mouhandiaye/Kicad/Models/Capacitance_To_Digital/RGH0016A.stp

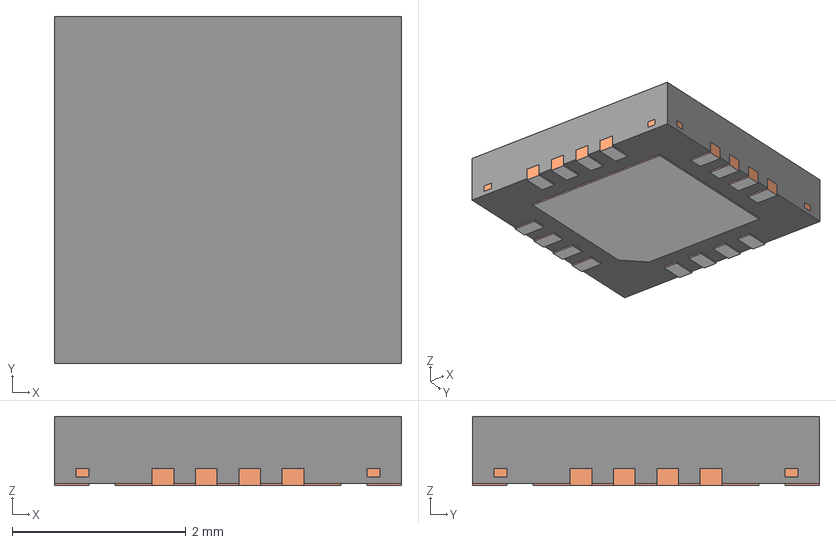
[picture p1: CAD file, 2022-08-02]
Models/Capacitance_To_Digital/RGH0016A.stp
4.00 x 4.00 x 0.8 mm
BODY-QFN
FRAME-RGH0016A
PIN1-ID
