mouhandiaye/Kicad/Models/CMS_ADC/ADS7028IRTER.stp

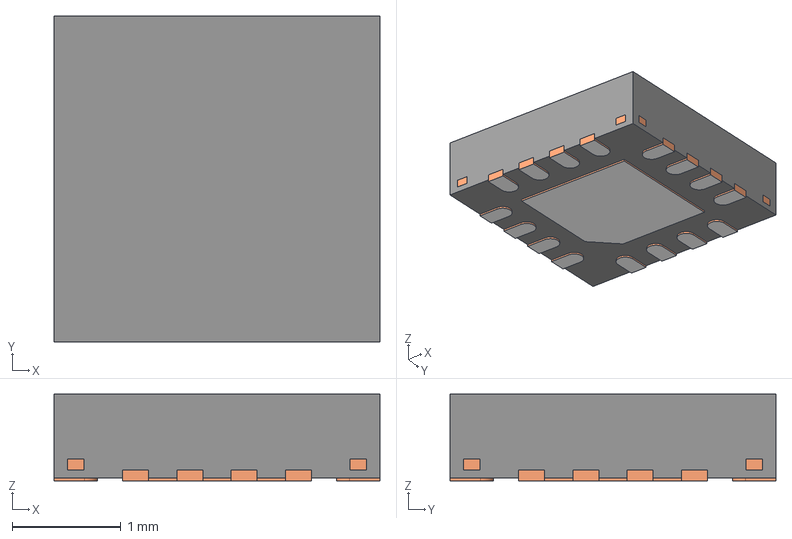
[picture p2: CAD file, 2022-08-26]
Models/CMS_ADC/ADS7028IRTER.stp
3.00 x 3.00 x 0.8 mm
BODY-QFN
FRAME-RTE0016C
PIN1-ID
