mouhandiaye/Kicad/Models/CMS_Antenna/ACAG0201-2450-T.stp

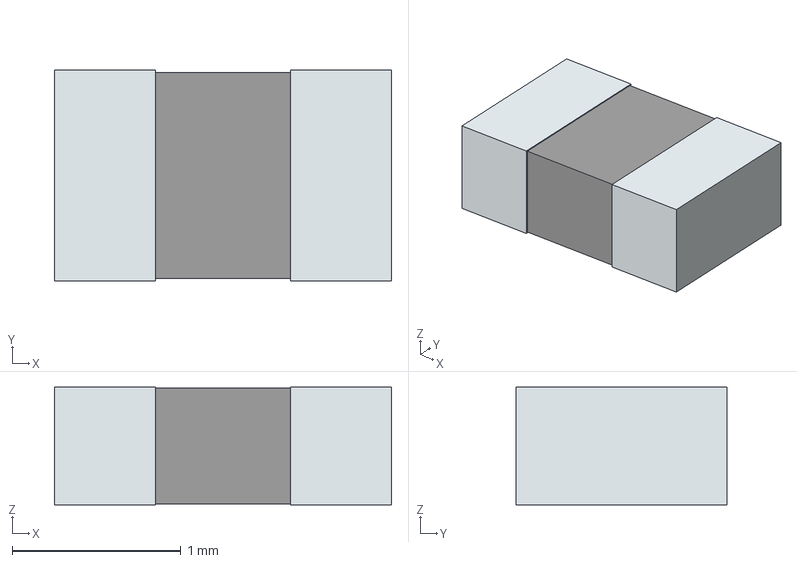
[picture p3: CAD file, 2022-08-25]
Models/CMS_Antenna/ACAG0201-2450-T.stp
2.00 x 1.25 x 0.7 mm
term1
term2
