mouhandiaye/Kicad/Models/CMS_AOP/MCP6N16-010E_MS.stp

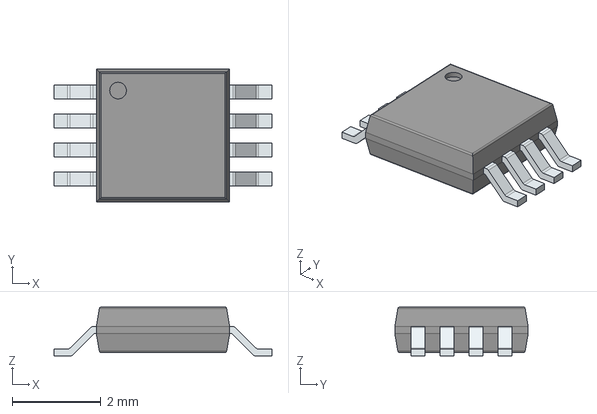
[picture p4: CAD file, 2022-08-02]
Models/CMS_AOP/MCP6N16-010E_MS.stp
4.90 x 3.00 x 1.10 mm
PinsArrayLR
