mouhandiaye/Kicad/Models/CMS_Capacitor/CAP_1608_TDK.step

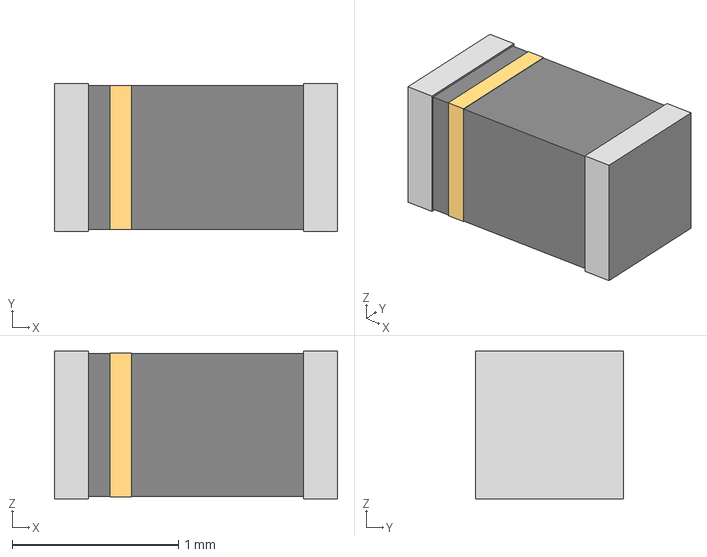
[picture p5: CAD file, 2022-08-02]
Models/CMS_Capacitor/CAP_1608_TDK.step
1.70 x 0.888 x 0.889 mm
