mouhandiaye/Kicad/Models/CMS_Counter/IC-MDTSSOP20.stp

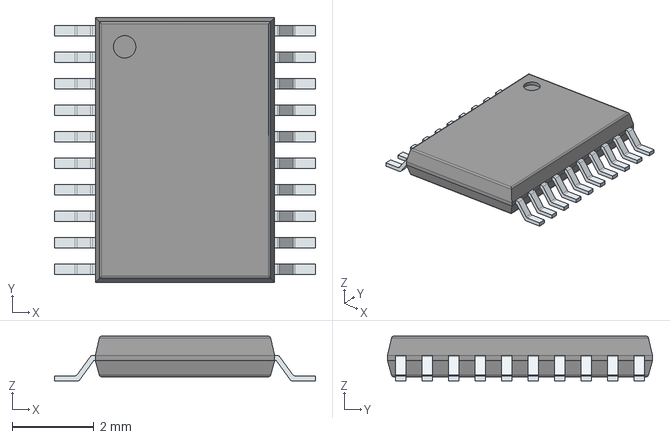
[picture p6: CAD file, 2022-08-02]
Models/CMS_Counter/IC-MDTSSOP20.stp
6.40 x 6.50 x 1.10 mm
PinsArrayLR
