mouhandiaye/Kicad/Models/CMS_DC_DC/LT3991EMSE-3.3PBF.stp

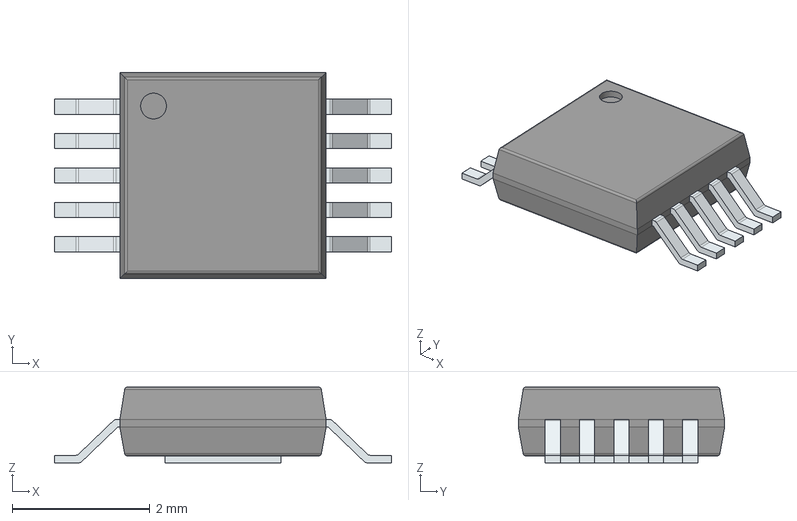
[picture p7: CAD file, 2022-08-25]
Models/CMS_DC_DC/LT3991EMSE-3.3PBF.stp
4.90 x 3.00 x 1.10 mm
PinsArrayLR
ThermalPad
