mouhandiaye/Kicad/Models/CMS_EEPROM/24FC512-I_MF.stp

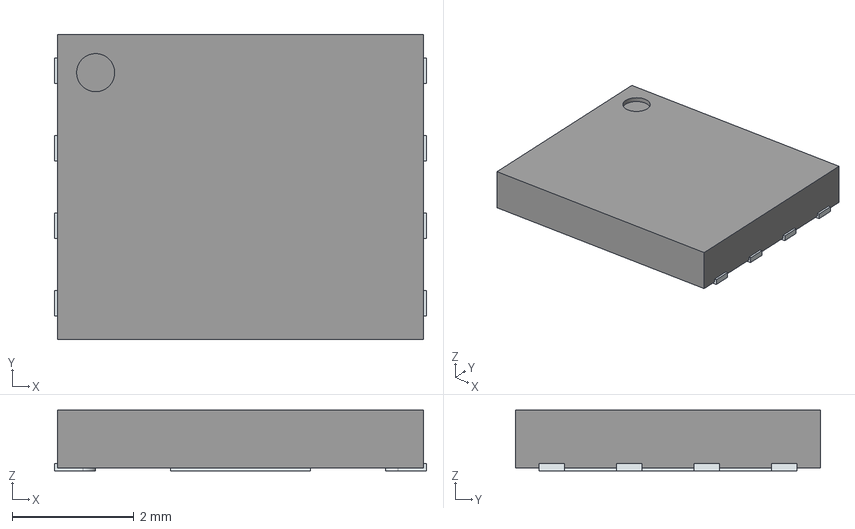
[picture p8: CAD file, 2022-08-25]
Models/CMS_EEPROM/24FC512-I_MF.stp
6.10 x 5.00 x 1.00 mm
ThermalPin
PinsArrayLR
