mouhandiaye/Kicad/Models/CMS_ESD_Protection/NSR0530HT1G.stp

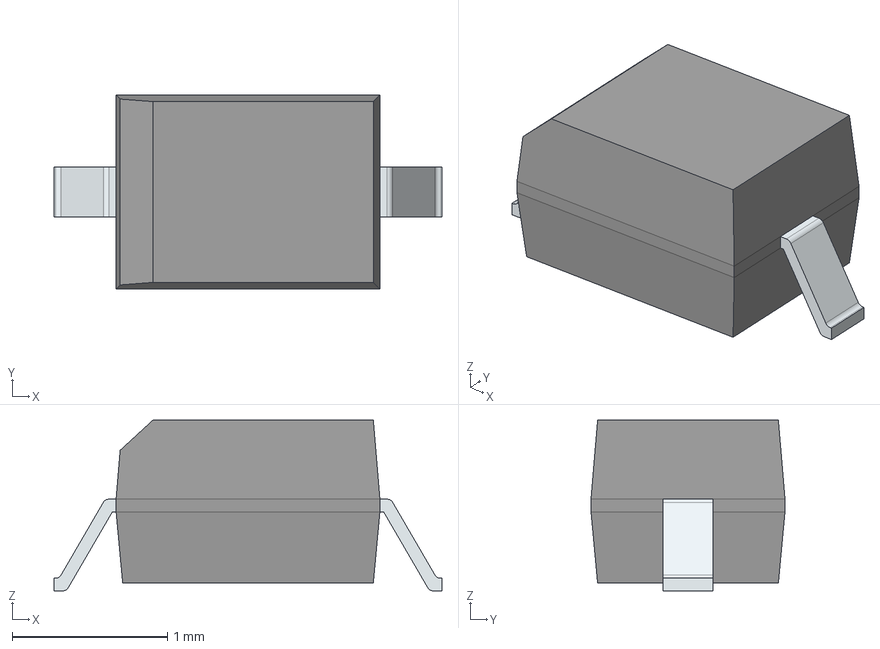
[picture p9: CAD file, 2022-08-26]
Models/CMS_ESD_Protection/NSR0530HT1G.stp
2.50 x 1.25 x 1.10 mm
FilletPinL
FilletPinR
