mouhandiaye/Kicad/Models/CMS_Ferrite/BLM18EG221SN1D.stp

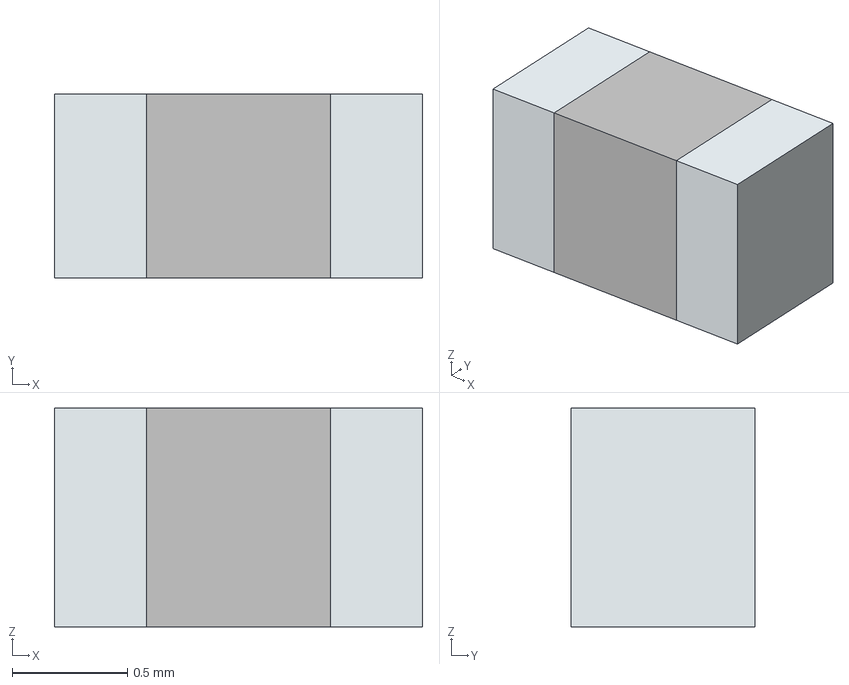
[picture p10: CAD file, 2022-08-25]
Models/CMS_Ferrite/BLM18EG221SN1D.stp
1.60 x 0.8 x 0.95 mm
solidBody
solidLead
