mouhandiaye/Kicad/Models/CMS_HARWIN/G125-MS11005L3P.stp

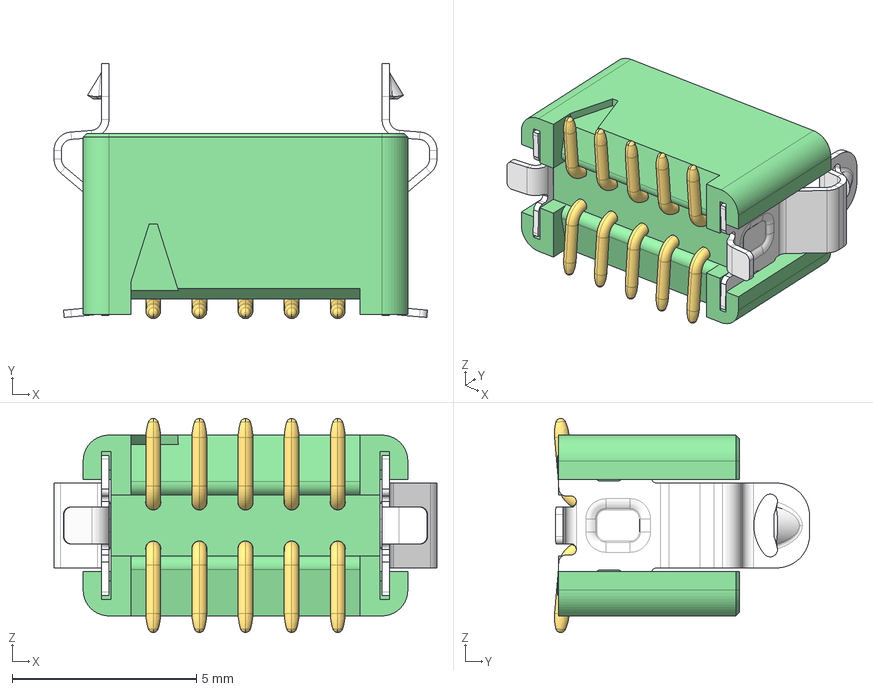
[picture p11: CAD file, 2022-08-02]
Models/CMS_HARWIN/G125-MS11005L3P.stp
10.4 x 6.92 x 5.80 mm
G125-3011096
G125-1050005_BENT x 10
G125-412 x 2
