mouhandiaye/Kicad/Models/CMS_HIROSE/BM46B-12DS-0.35V_51_.step

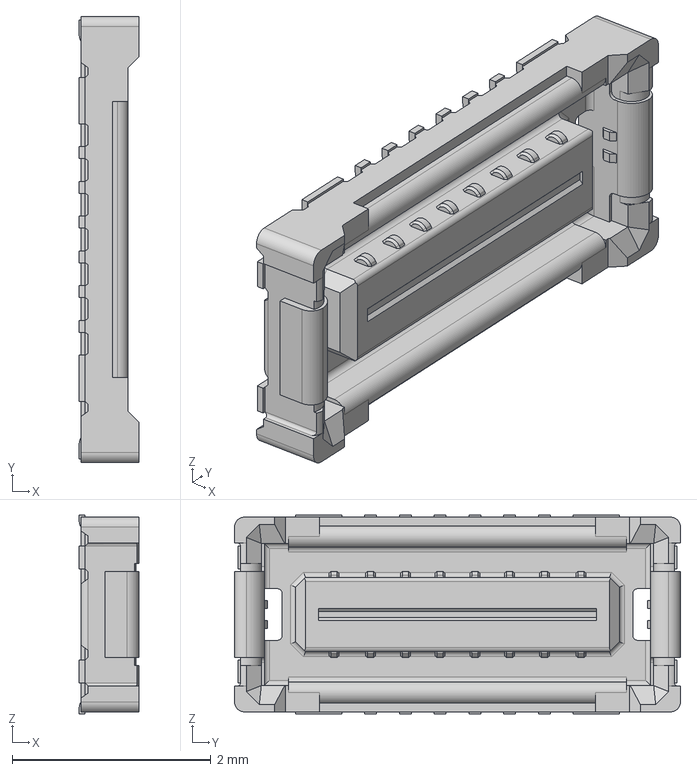
[picture p12: CAD file, 2022-08-02]
Models/CMS_HIROSE/BM46B-12DS-0.35V_51_.step
0.6 x 4.49 x 2.00 mm
