mouhandiaye/Kicad/Models/CMS_HIROSE/DF12N/DF12NB(3.0)-80DS.stp

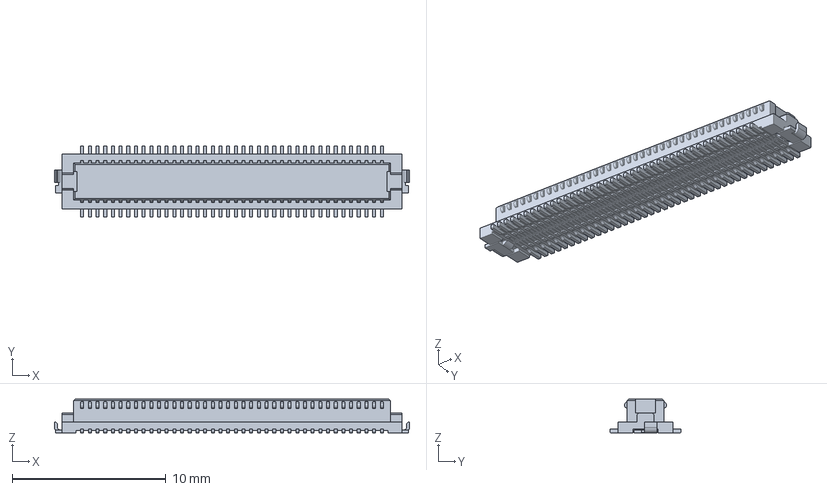
[picture p13: CAD file, 2022-08-02]
Models/CMS_HIROSE/DF12N/DF12NB(3.0)-80DS.stp
23.1 x 4.60 x 2.20 mm
