mouhandiaye/Kicad/Models/CMS_IMU/LSM6DS3TR-C.stp

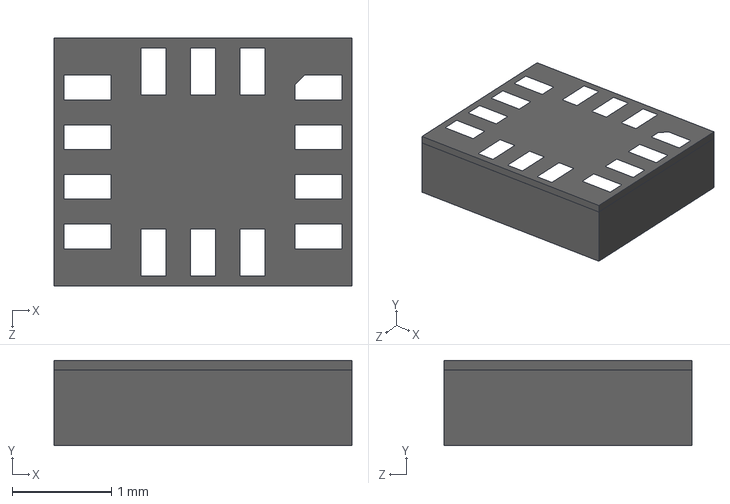
[picture p14: CAD file, 2022-08-25]
Models/CMS_IMU/LSM6DS3TR-C.stp
3.00 x 0.86 x 2.50 mm
