mouhandiaye/Kicad/Models/CMS_LAN/LAN9252I_PT.stp

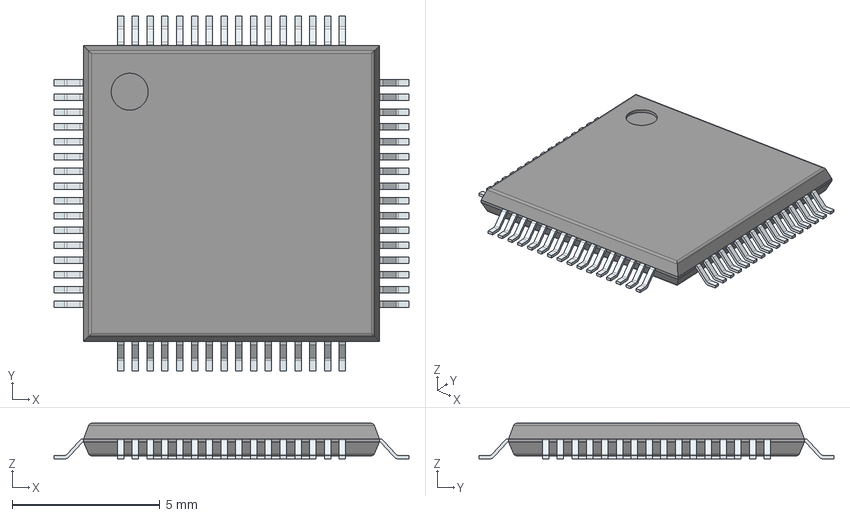
[picture p15: CAD file, 2022-08-25]
Models/CMS_LAN/LAN9252I_PT.stp
12.0 x 12.0 x 1.20 mm
PinsArrayLR
PinsArrayTB
ThermalPad
