mouhandiaye/Kicad/Models/CMS_Led/LED_150120RS75000_WRE.step

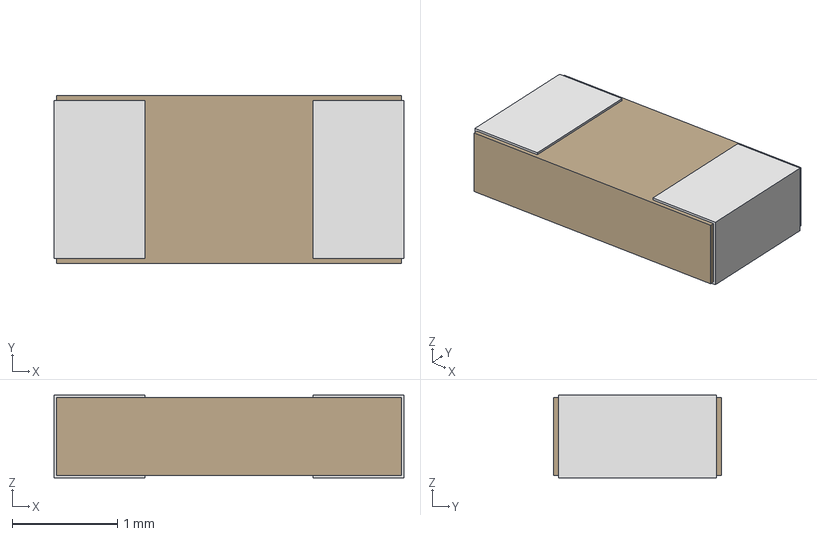
[picture p16: CAD file, 2022-08-02]
Models/CMS_Led/LED_150120RS75000_WRE.step
3.33 x 1.60 x 0.787 mm
