mouhandiaye/Kicad/Models/CMS_LEVEL_SHIFT/21-0137I_T1433-2_MXM.step

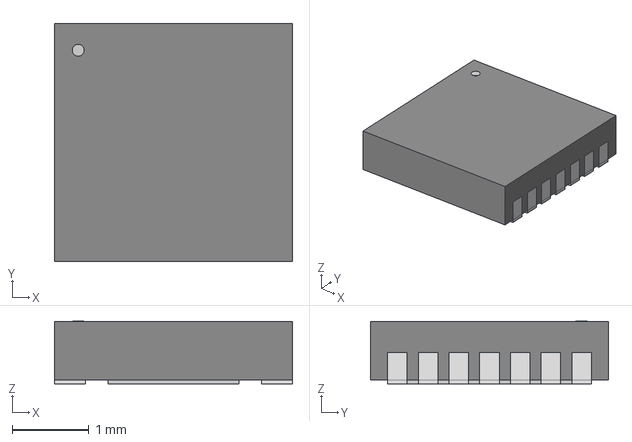
[picture p17: CAD file, 2022-08-02]
Models/CMS_LEVEL_SHIFT/21-0137I_T1433-2_MXM.step
3.10 x 3.10 x 0.815 mm
