mouhandiaye/Kicad/Models/CMS_Logic/NAND/74AHCT2G08DP_125_NEX.step

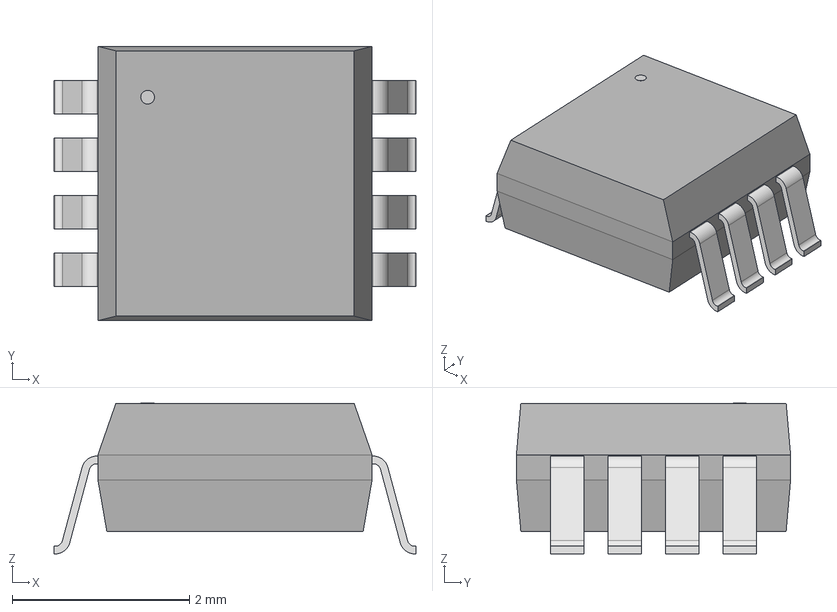
[picture p18: CAD file, 2022-08-02]
Models/CMS_Logic/NAND/74AHCT2G08DP_125_NEX.step
4.09 x 3.10 x 1.70 mm
