mouhandiaye/Kicad/Models/CMS_Magnetometer/LIS2MDLTR.stp

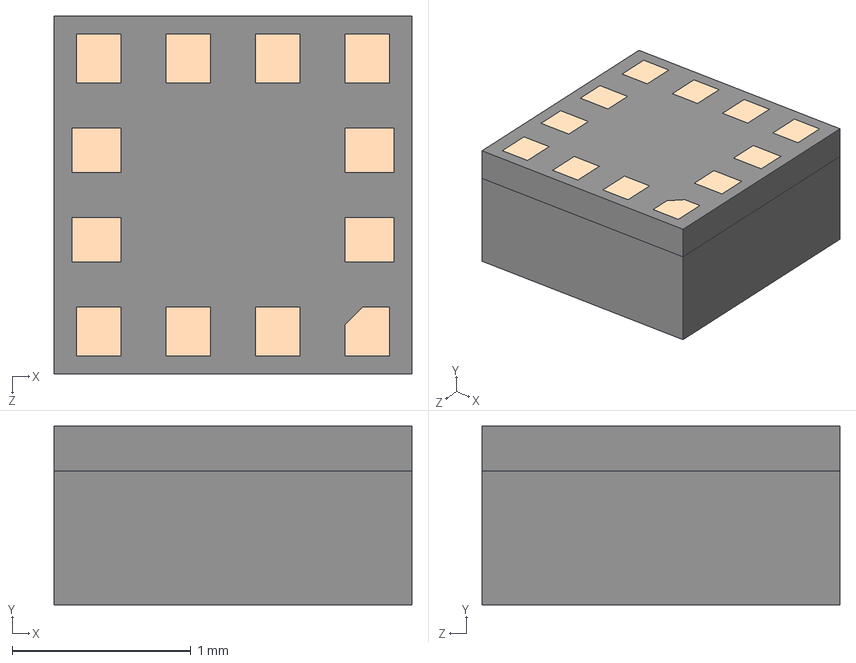
[picture p19: CAD file, 2022-08-02]
Models/CMS_Magnetometer/LIS2MDLTR.stp
2.00 x 1.00 x 2.00 mm
