mouhandiaye/Kicad/Models/CMS_MCU/STM32L010K4T6.stp

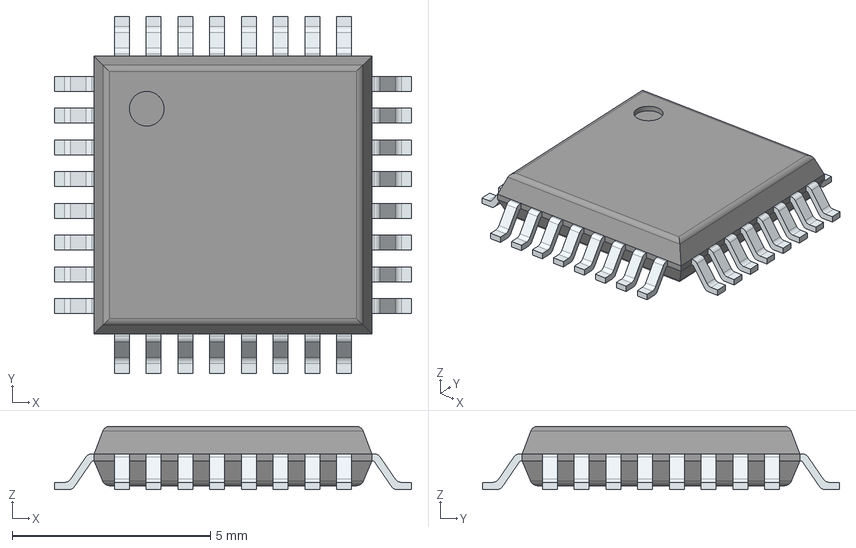
[picture p20: CAD file, 2022-08-02]
Models/CMS_MCU/STM32L010K4T6.stp
9.00 x 9.00 x 1.60 mm
PinsArrayLR
PinsArrayTB
