mouhandiaye/Kicad/Models/CMS_Oscillator/MCSJK-3N-25.00-3.3-25-B.stp

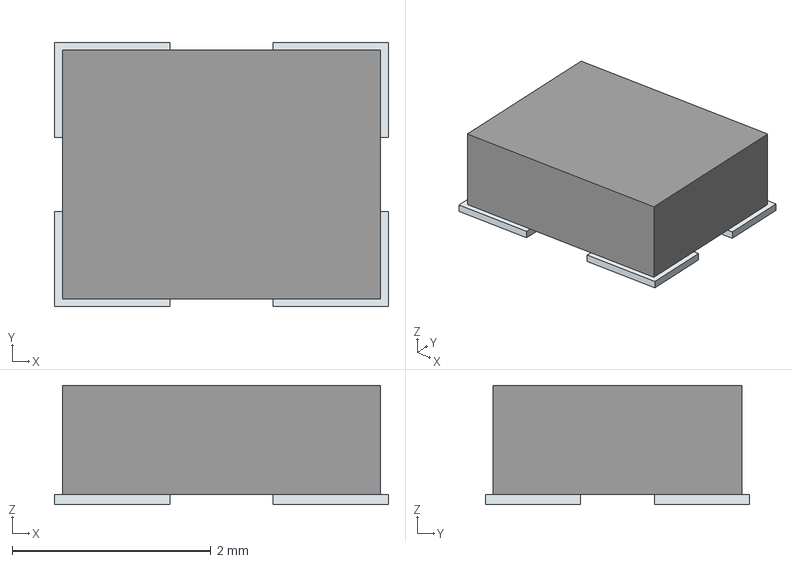
[picture p21: CAD file, 2022-08-02]
Models/CMS_Oscillator/MCSJK-3N-25.00-3.3-25-B.stp
3.36 x 2.66 x 1.20 mm
Pins
