mouhandiaye/Kicad/Models/CMS_Push_Button/KMR223GLFG.stp

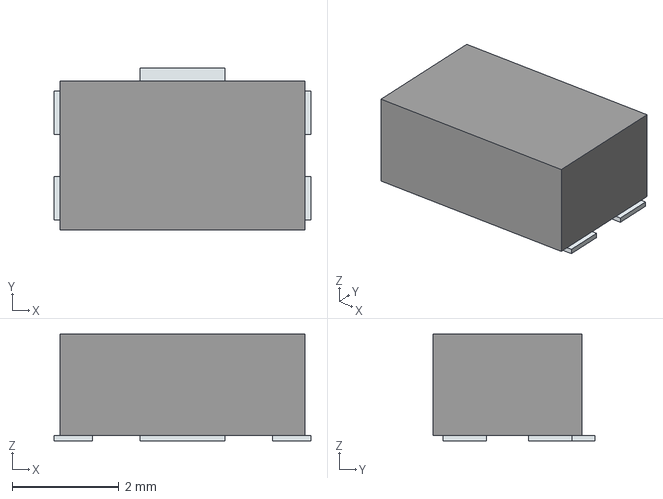
[picture p22: CAD file, 2022-08-26]
Models/CMS_Push_Button/KMR223GLFG.stp
4.82 x 3.04 x 2.00 mm
Pins
