mouhandiaye/Kicad/Models/CMS_Quartz/8Z-25.000MAAJ-T.stp

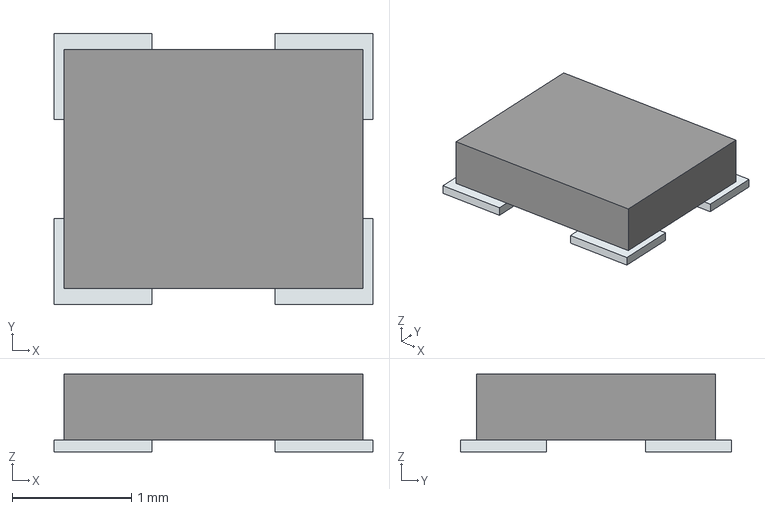
[picture p23: CAD file, 2022-08-25]
Models/CMS_Quartz/8Z-25.000MAAJ-T.stp
2.67 x 2.27 x 0.65 mm
Pins
