mouhandiaye/Kicad/Models/CMS_Rectifier/RBS1MM40ATR.stp

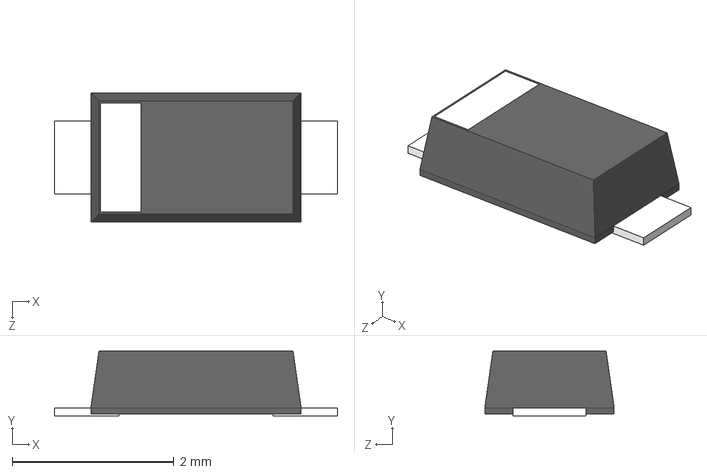
[picture p24: CAD file, 2022-08-25]
Models/CMS_Rectifier/RBS1MM40ATR.stp
3.50 x 0.8 x 1.60 mm
