mouhandiaye/Kicad/Models/CMS_Resistor/RC0603N_YAG.step

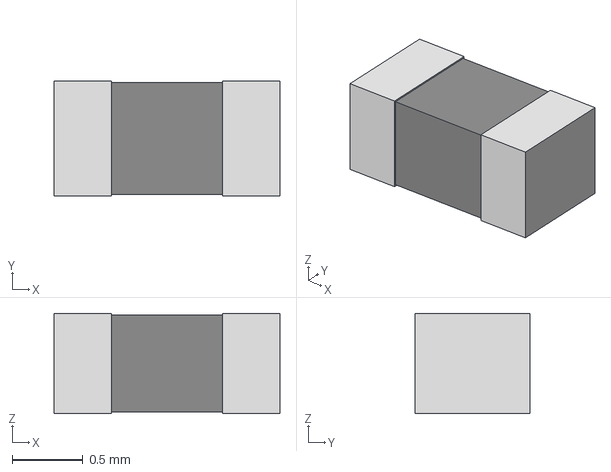
[picture p25: CAD file, 2022-08-02]
Models/CMS_Resistor/RC0603N_YAG.step
1.60 x 0.812 x 0.711 mm
