mouhandiaye/Kicad/Models/CMS_Samtec/LSHM-120-02.5-L-DV-A-S-K-TR.step

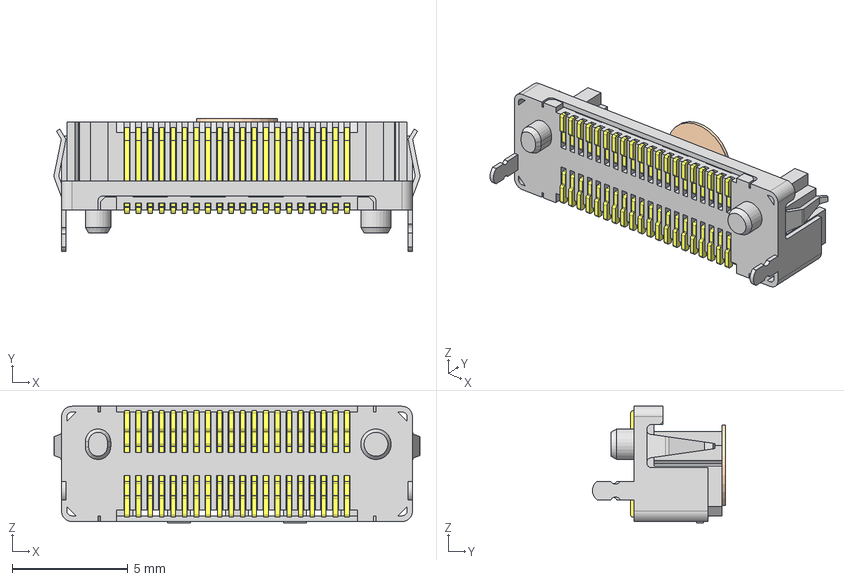
[picture p26: CAD file, 2022-08-25]
Models/CMS_Samtec/LSHM-120-02.5-L-DV-A-S-K-TR.step
15.8 x 5.75 x 5.03 mm
K-DOT-.138-.250-.005.pp
C-185--20-02.5-DV1P
LSHM-20-02.5-DV-A-S_STRIP
