mouhandiaye/Kicad/Models/CMS_Schottky/DSN2.step

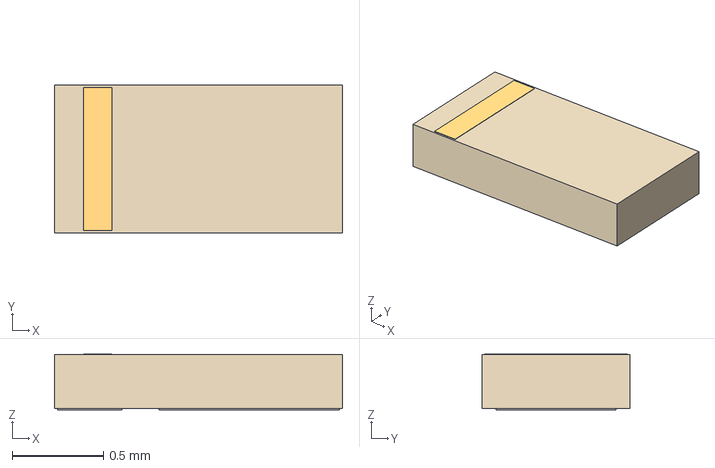
[picture p27: CAD file, 2022-08-25]
Models/CMS_Schottky/DSN2.step
1.58 x 0.812 x 0.307 mm
