mouhandiaye/Kicad/Models/CMS_Transformer&Choke/ALT4532M-201-T001.stp

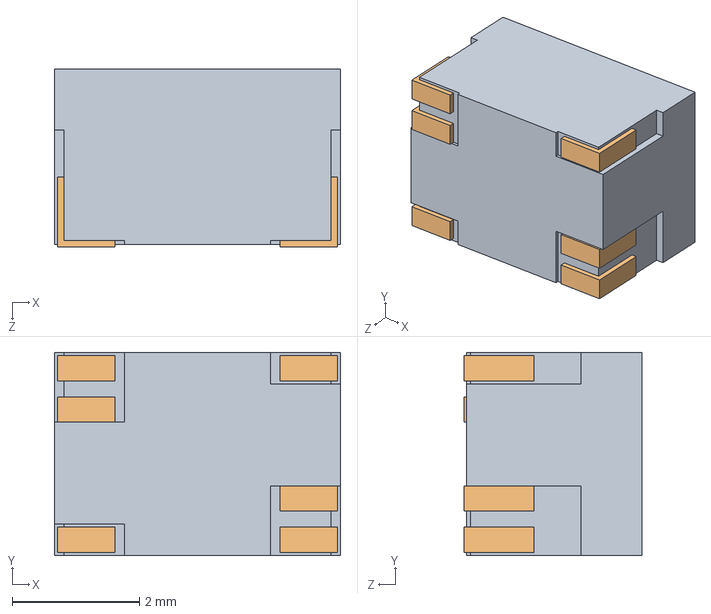
[picture p28: CAD file, 2022-08-25]
Models/CMS_Transformer&Choke/ALT4532M-201-T001.stp
4.50 x 3.20 x 2.80 mm
ALT4532M-201 DRコアブロック(typ size)
ALT4532M-201 端子ブロック(typ size) x 6
