mouhandiaye/Kicad/Models/CMS_Voltage_Regulator/SOT23-5L_STM.step

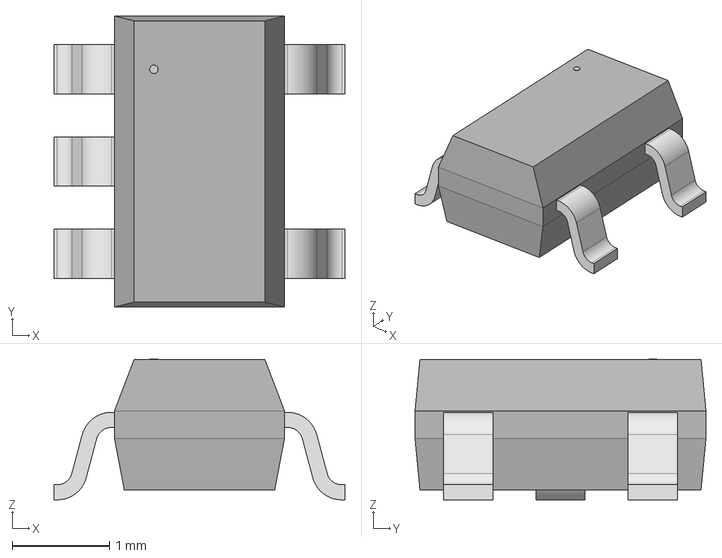
[picture p29: CAD file, 2022-08-02]
Models/CMS_Voltage_Regulator/SOT23-5L_STM.step
3.00 x 3.00 x 1.45 mm
