mouhandiaye/Kicad/Models/FPC/F32R-1A7H1-11008.stp

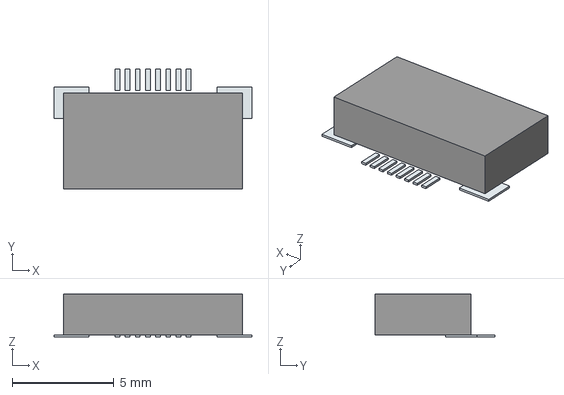
[picture p30: CAD file, 2022-08-02]
Models/FPC/F32R-1A7H1-11008.stp
9.71 x 5.87 x 2.10 mm
Pins
