mouhandiaye/Kicad/Models/CMS_Antenna/MLPF-WB55-02E3.stp

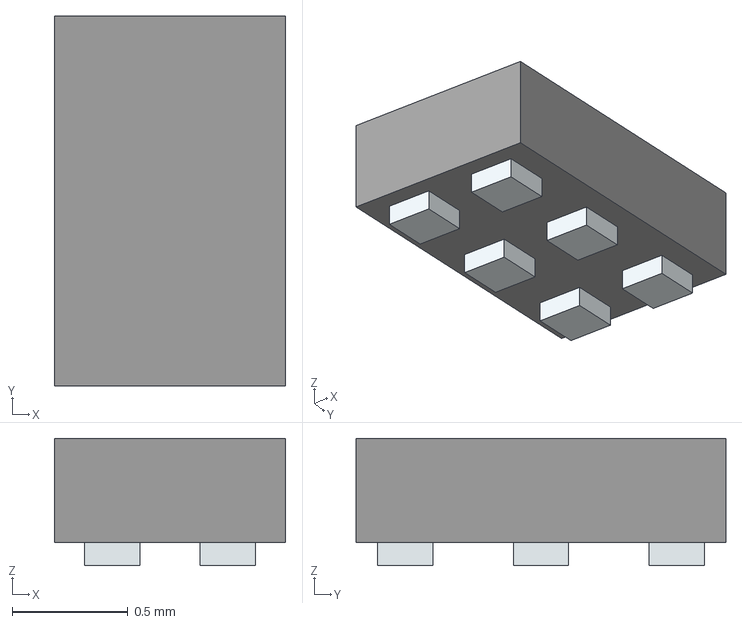
[picture p32: CAD file, 2022-08-25]
Models/CMS_Antenna/MLPF-WB55-02E3.stp
1.00 x 1.60 x 0.55 mm
Pins
