mouhandiaye/Kicad/Models/CMS_BATT_CHARG/DFN8_2x3MC_MCH.step

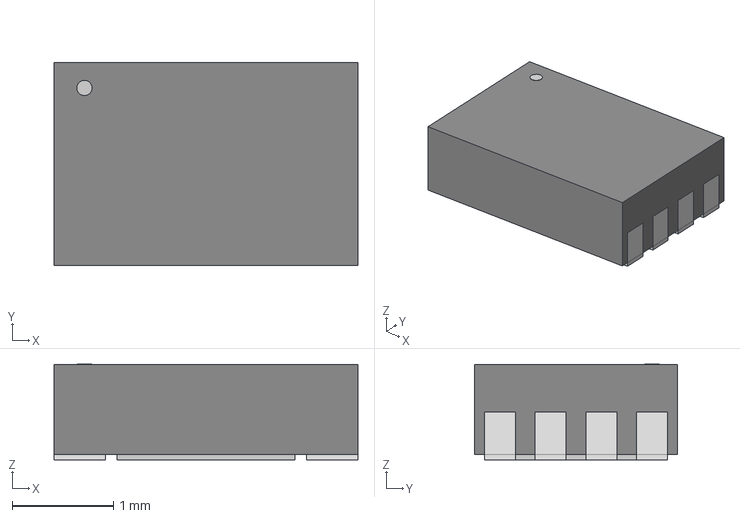
[picture p33: CAD file, 2022-08-02]
Models/CMS_BATT_CHARG/DFN8_2x3MC_MCH.step
3.00 x 2.01 x 0.942 mm
