mouhandiaye/Kicad/Models/CMS_Capacitor/YAG_CC0402_YAG.step

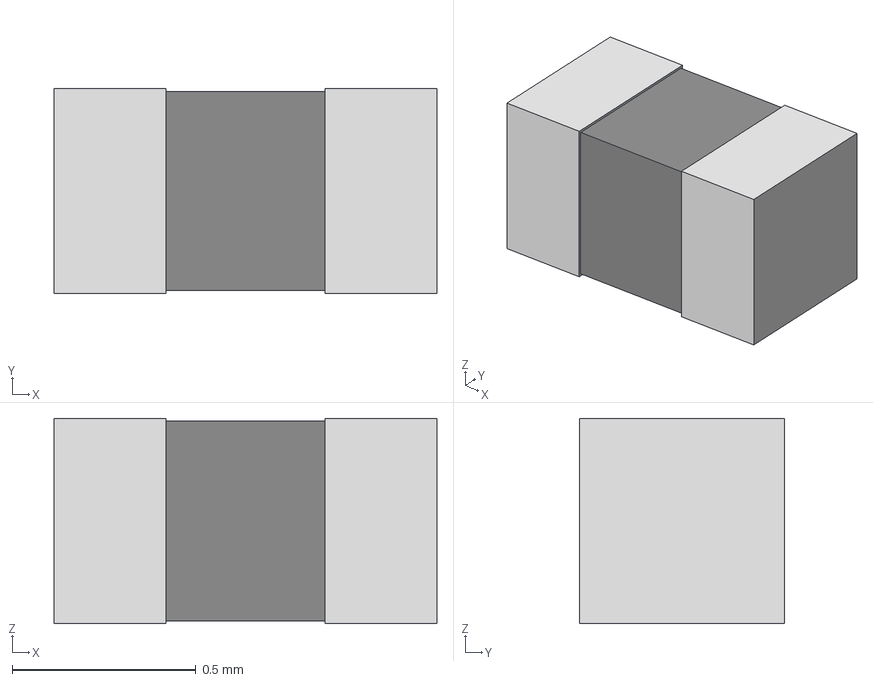
[picture p34: CAD file, 2022-08-02]
Models/CMS_Capacitor/YAG_CC0402_YAG.step
1.04 x 0.558 x 0.559 mm
