mouhandiaye/Kicad/Models/CMS_Ferrite/IND_1005_TDK.step

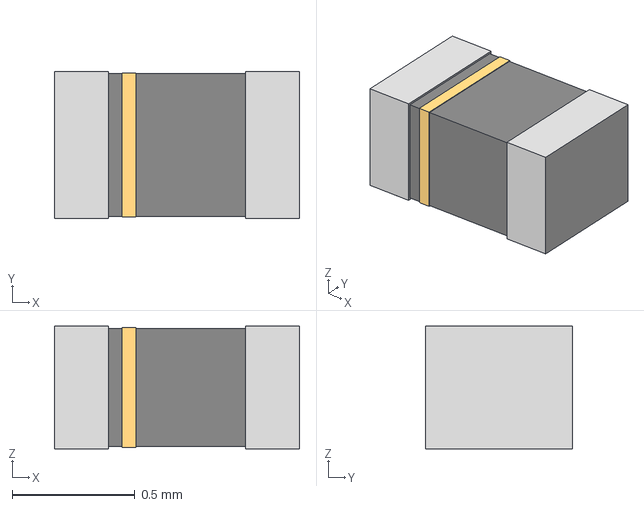
[picture p35: CAD file, 2022-08-02]
Models/CMS_Ferrite/IND_1005_TDK.step
1.00 x 0.6 x 0.5 mm
