mouhandiaye/Kicad/Models/CMS_HIROSE/BM46B-12DP-0.35V_51_.step

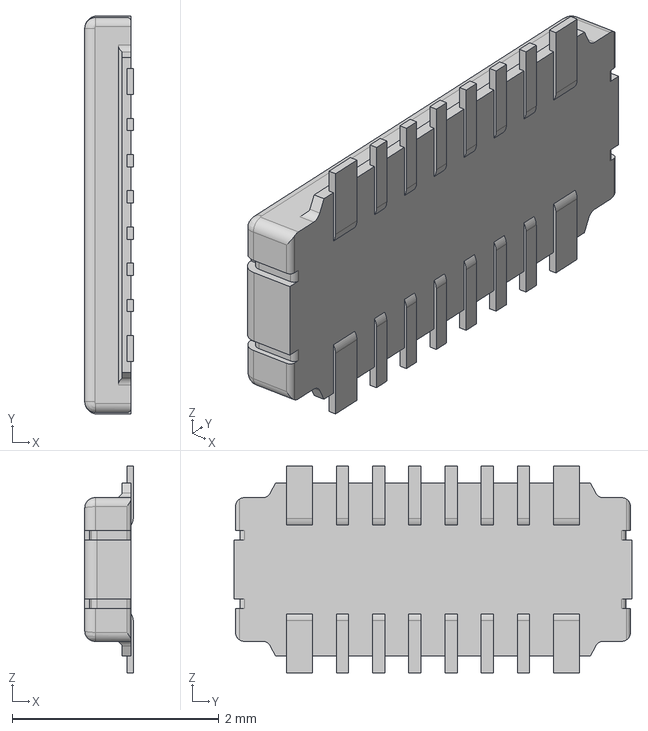
[picture p36: CAD file, 2022-08-02]
Models/CMS_HIROSE/BM46B-12DP-0.35V_51_.step
0.47 x 3.85 x 2.00 mm
