mouhandiaye/Kicad/Models/CMS_HIROSE/DF12N/DF12NB(3.0)-60DS.stp

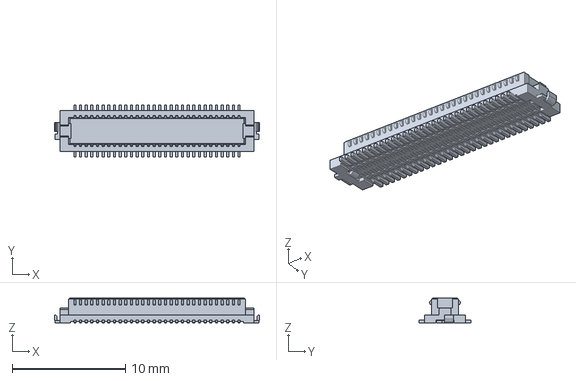
[picture p37: CAD file, 2022-08-02]
Models/CMS_HIROSE/DF12N/DF12NB(3.0)-60DS.stp
18.1 x 4.60 x 2.20 mm
