mouhandiaye/Kicad/Models/CMS_IMU/QFN_6DSLTR_STM.step

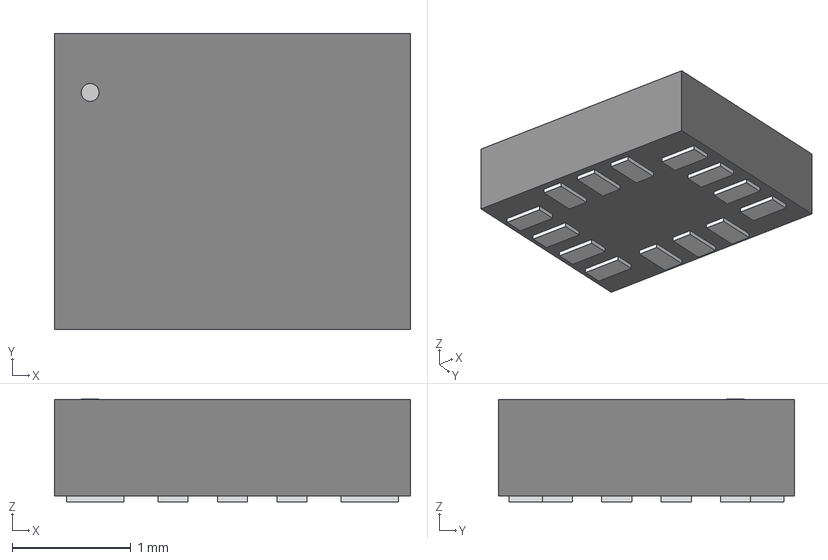
[picture p38: CAD file, 2022-08-02]
Models/CMS_IMU/QFN_6DSLTR_STM.step
3.00 x 2.49 x 0.866 mm
