mouhandiaye/Kicad/Models/CMS_Inductor/LPS5030-123MRC.step

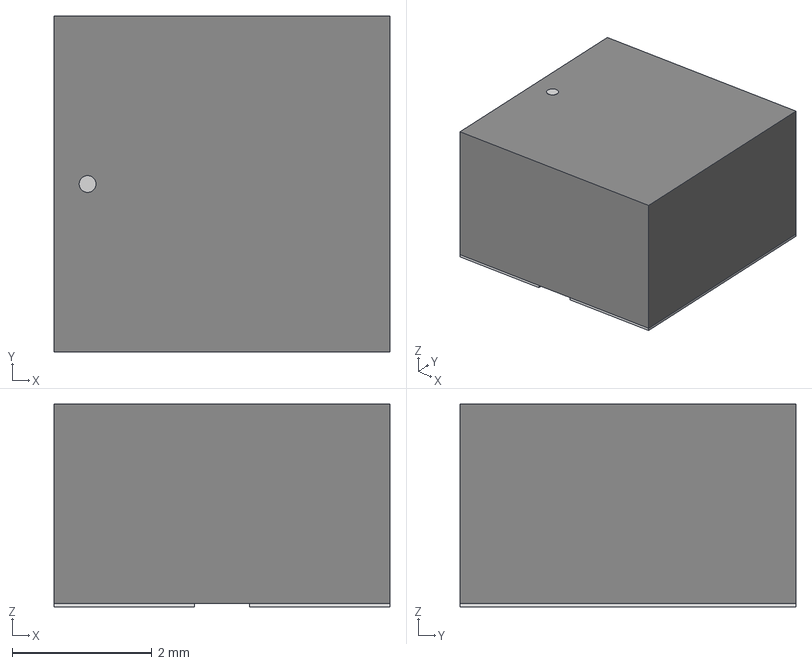
[picture p39: CAD file, 2022-08-25]
Models/CMS_Inductor/LPS5030-123MRC.step
4.80 x 4.80 x 2.90 mm
