mouhandiaye/Kicad/Models/CMS_LEVEL_SHIFT/FXLA0104QFX.stp

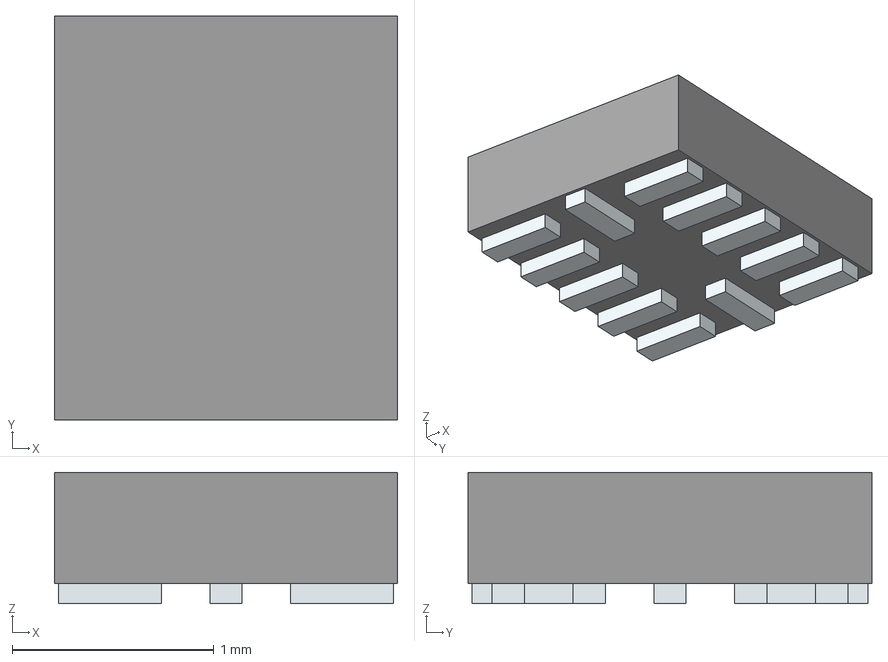
[picture p40: CAD file, 2022-08-02]
Models/CMS_LEVEL_SHIFT/FXLA0104QFX.stp
1.70 x 2.00 x 0.65 mm
Pins
