mouhandiaye/Kicad/Models/CMS_Magnetometer/WLP4_0P82X0P82_MEM.step

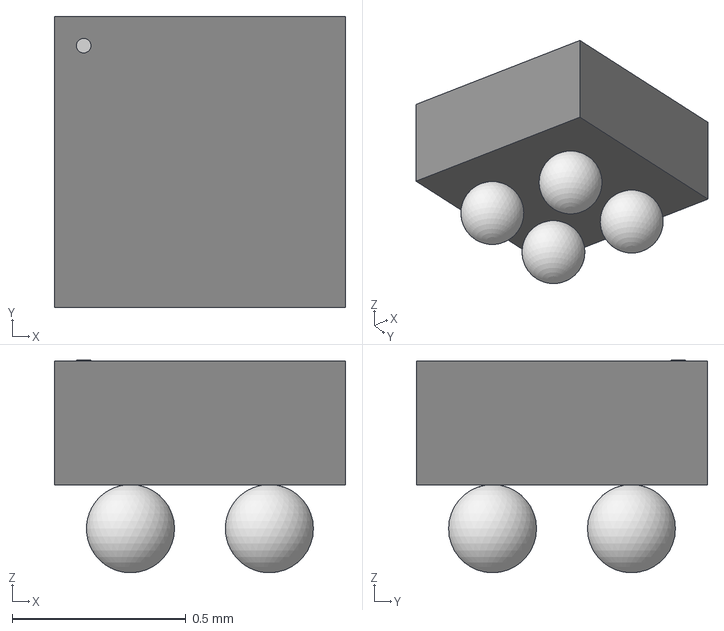
[picture p41: CAD file, 2022-08-02]
Models/CMS_Magnetometer/WLP4_0P82X0P82_MEM.step
0.838 x 0.838 x 0.612 mm
