mouhandiaye/Kicad/Models/CMS_MCU/LQFP-64.step

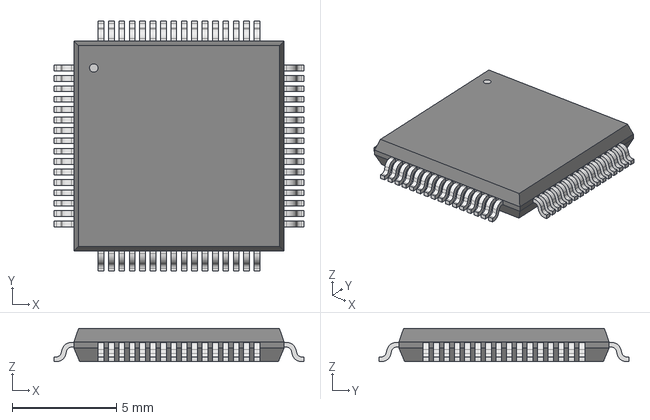
[picture p42: CAD file, 2022-08-02]
Models/CMS_MCU/LQFP-64.step
12.0 x 12.0 x 1.60 mm
