mouhandiaye/Kicad/Models/CMS_Push_Button/PTS647SM70SMTR2LFS.stp

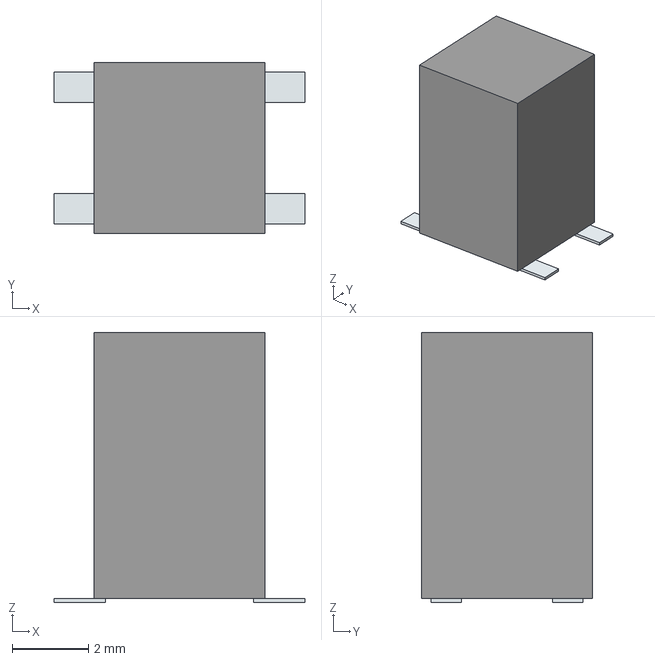
[picture p43: CAD file, 2022-08-25]
Models/CMS_Push_Button/PTS647SM70SMTR2LFS.stp
6.60 x 4.50 x 7.10 mm
Pins
