mouhandiaye/Kicad/Models/CMS_Quartz/XTAL_SC-20S_EPS.step

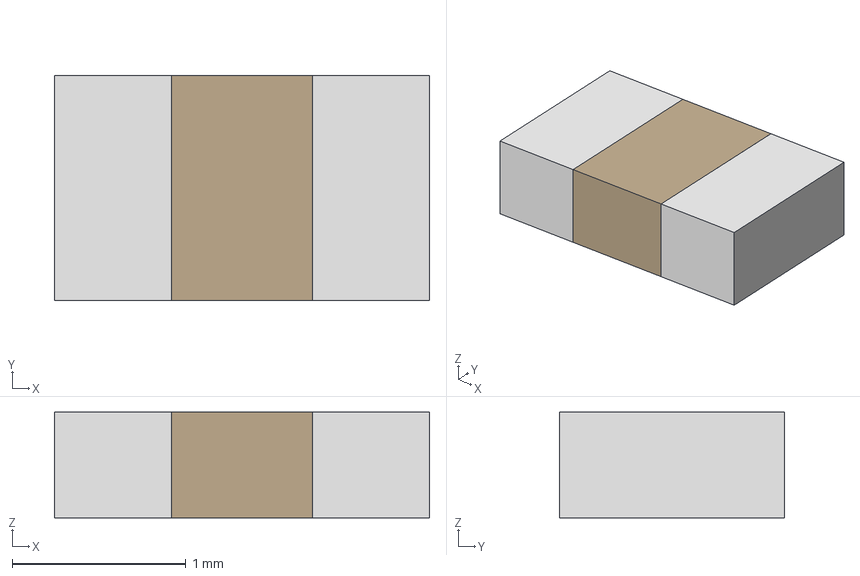
[picture p44: CAD file, 2022-08-25]
Models/CMS_Quartz/XTAL_SC-20S_EPS.step
2.16 x 1.30 x 0.61 mm
