mouhandiaye/Kicad/Models/CMS_Resistor/YAG_AC0402_YAG.step

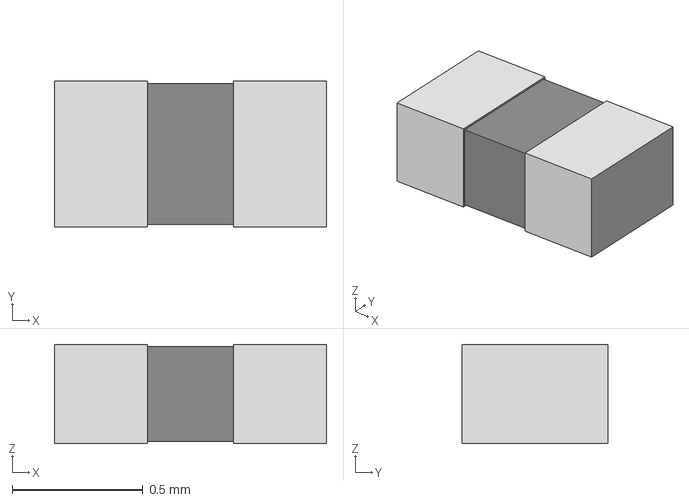
[picture p45: CAD file, 2022-08-02]
Models/CMS_Resistor/YAG_AC0402_YAG.step
1.04 x 0.558 x 0.381 mm
