mouhandiaye/Kicad/Models/CMS_Samtec/LSHM-105-02.5-L-DV-A-S-K-TR.stp

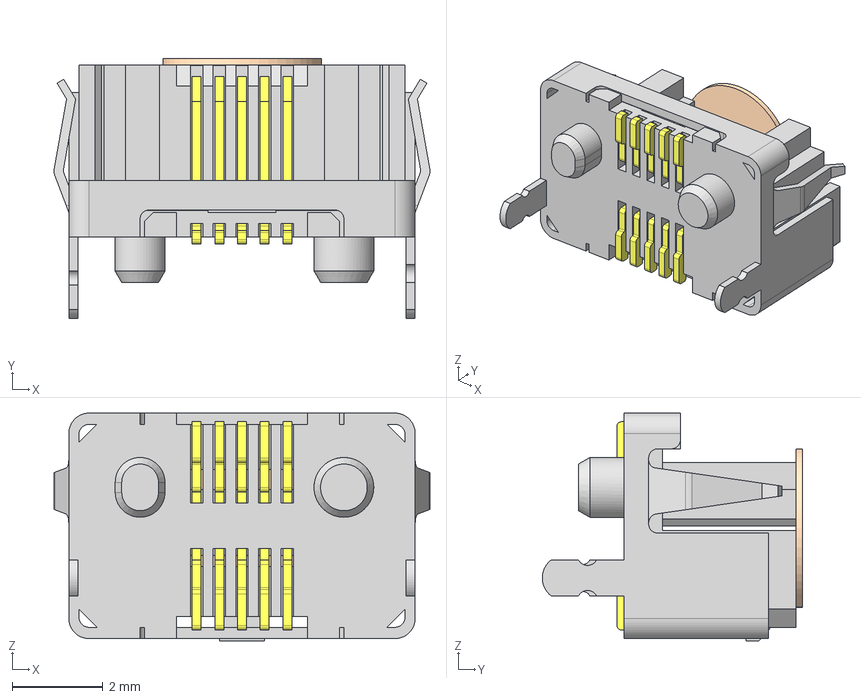
[picture p46: CAD file, 2022-08-25]
Models/CMS_Samtec/LSHM-105-02.5-L-DV-A-S-K-TR.stp
8.30 x 5.75 x 5.03 mm
K-DOT-.138-.250-.005.pp
C-185--05-02.5-DV1P
LSHM-05-02.5-DV-A-S_STRIP
