mouhandiaye/Kicad/Models/CMS_Schottky/MBRA210LT3G.stp

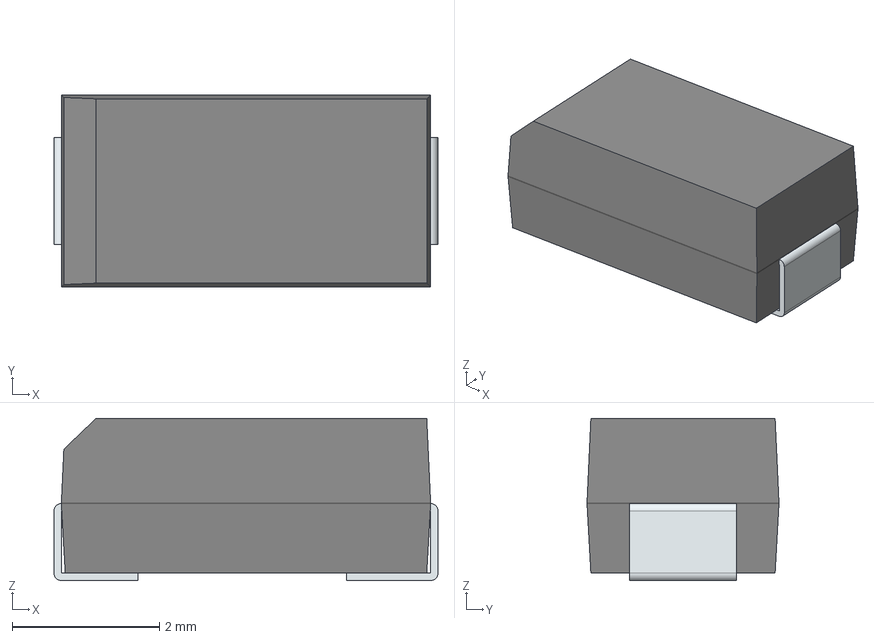
[picture p47: CAD file, 2022-08-25]
Models/CMS_Schottky/MBRA210LT3G.stp
5.21 x 2.60 x 2.20 mm
FilletPin1
FilletPin2
