mouhandiaye/Kicad/Models/CMS_Transformer&Choke/ACM2012-121-2P-T001.stp

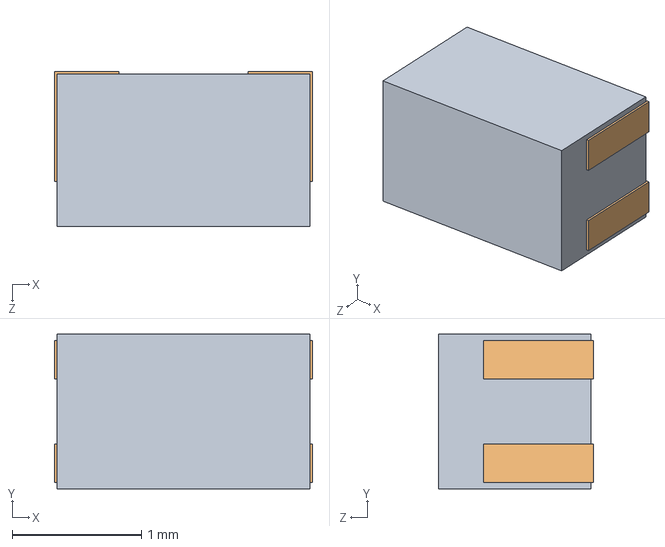
[picture p48: CAD file, 2022-08-25]
Models/CMS_Transformer&Choke/ACM2012-121-2P-T001.stp
2.00 x 1.20 x 1.20 mm
ACM2012-T002 DRコアブロック(typ size)
ACM2012-T002 電極ブロック(typ size) x 4
