mouhandiaye/Kicad/Models/Package/VFQFPN68.stp

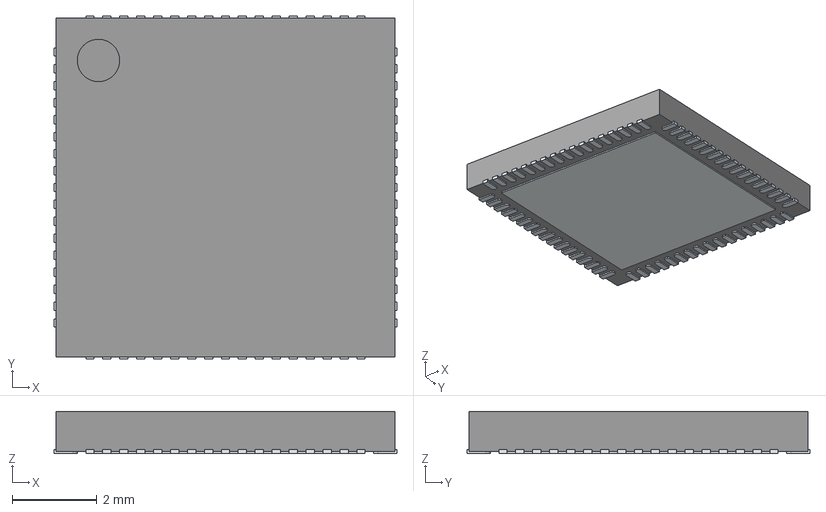
[picture p49: CAD file, 2022-08-25]
Models/Package/VFQFPN68.stp
8.10 x 8.10 x 1.00 mm
ThermalPin
PinsArrayLR
PinsArrayTB
