mouhandiaye/Kicad/Models/CMS_AOP/NHK0014A.stp

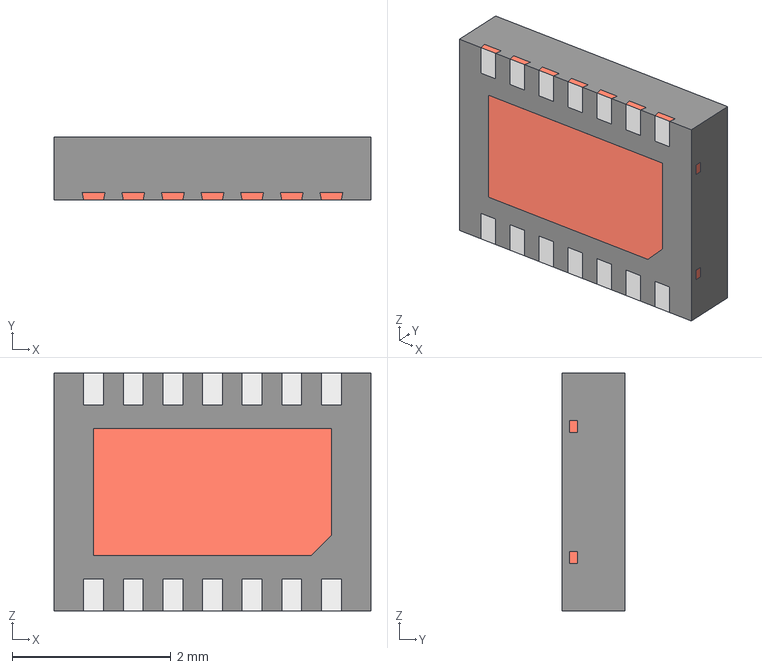
[picture p50: CAD file, 2022-08-02]
Models/CMS_AOP/NHK0014A.stp
4.00 x 0.8 x 3.00 mm
BODY_SDA14A
FRAME_SDA14A
