mouhandiaye/Kicad/Models/CMS_Capacitor/CCS_CCSTD_0402_L1.05W0.55T0.55B0.3.step

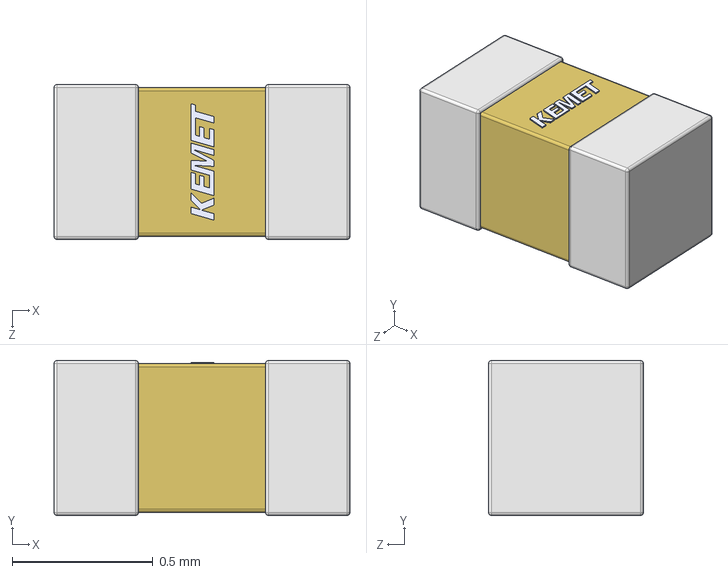
[picture p51: CAD file, 2022-08-02]
Models/CMS_Capacitor/CCS_CCSTD_0402_L1.05W0.55T0.55B0.3.step
1.05 x 0.55 x 0.55 mm
