mouhandiaye/Kicad/Models/CMS_ESD_Protection/ESDA25-4BP6.step

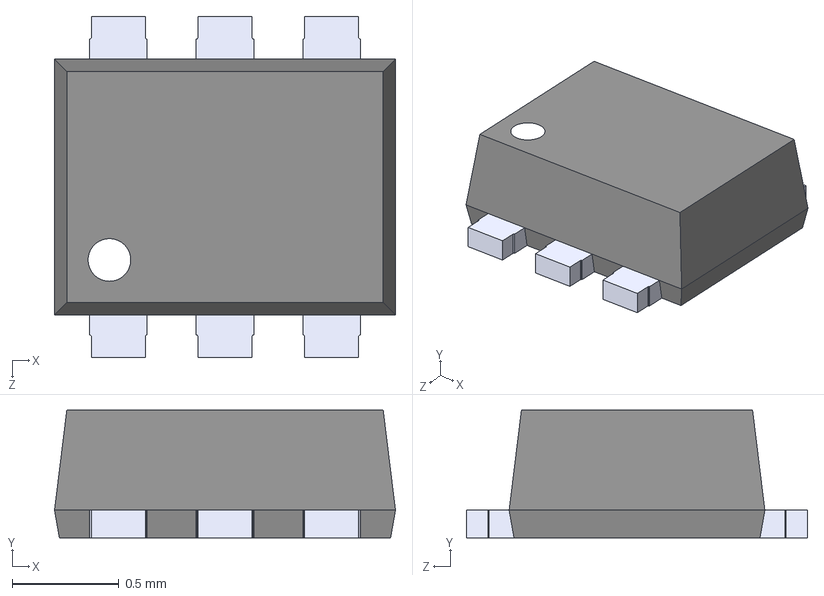
[picture p52: CAD file, 2022-08-02]
Models/CMS_ESD_Protection/ESDA25-4BP6.step
1.60 x 0.6 x 1.60 mm
