mouhandiaye/Kicad/Models/CMS_IMU/QFN_S3TR-C_STM.step

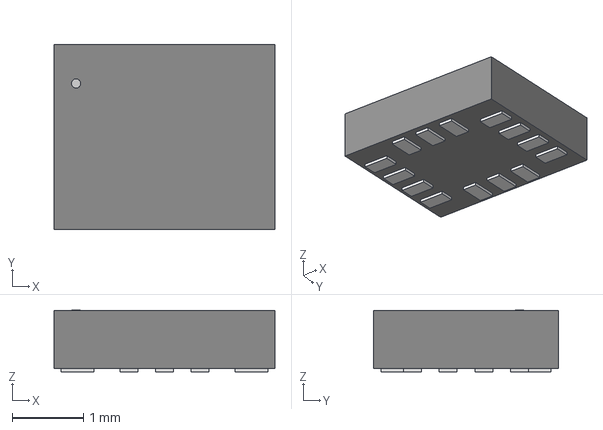
[picture p53: CAD file, 2022-08-02]
Models/CMS_IMU/QFN_S3TR-C_STM.step
3.10 x 2.59 x 0.866 mm
