mouhandiaye/Kicad/Models/CMS_Inductor/LQW15AN3N8D10D.stp

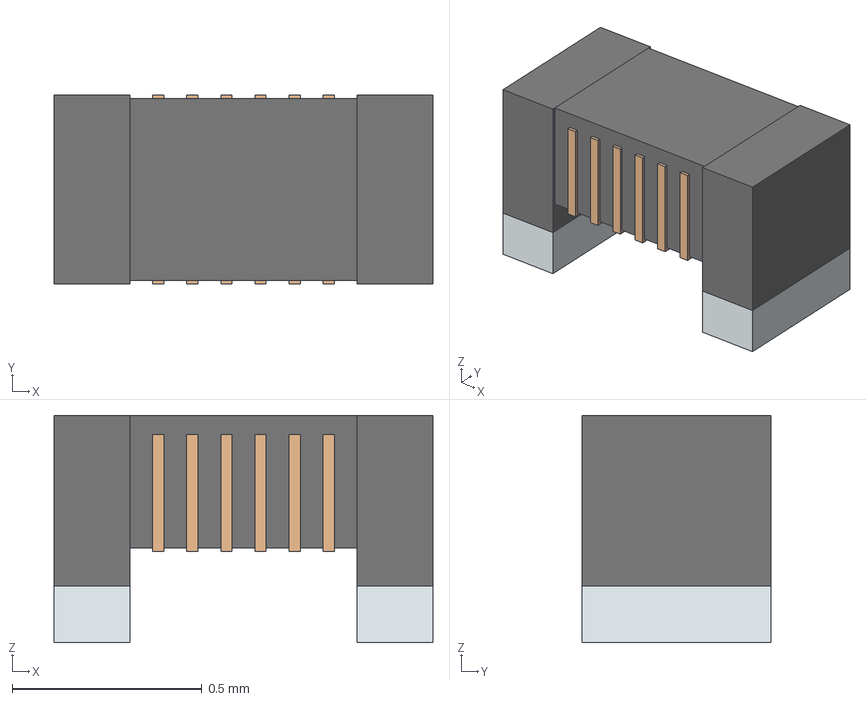
[picture p54: CAD file, 2022-08-25]
Models/CMS_Inductor/LQW15AN3N8D10D.stp
1.00 x 0.5 x 0.6 mm
Rect1
Rect2
Rect3
Rect4
Rect5
Rect6
Rect7
Rect8
Rect9
Rect10
Rect11
