mouhandiaye/Kicad/Models/CMS_Quartz/ECS-320-8-37-CKM-TR3.stp

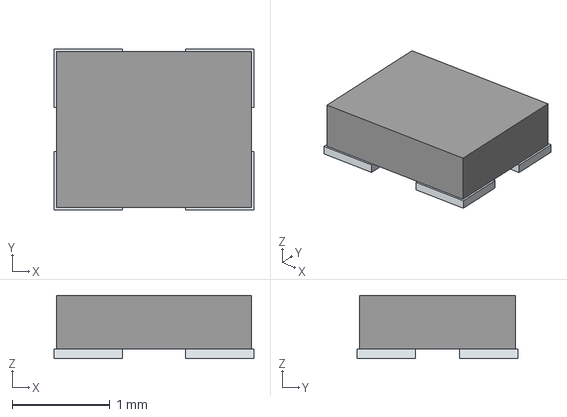
[picture p55: CAD file, 2022-08-25]
Models/CMS_Quartz/ECS-320-8-37-CKM-TR3.stp
2.05 x 1.65 x 0.65 mm
Pins
