mouhandiaye/Kicad/Models/Package/SOT323-3L_STM.step

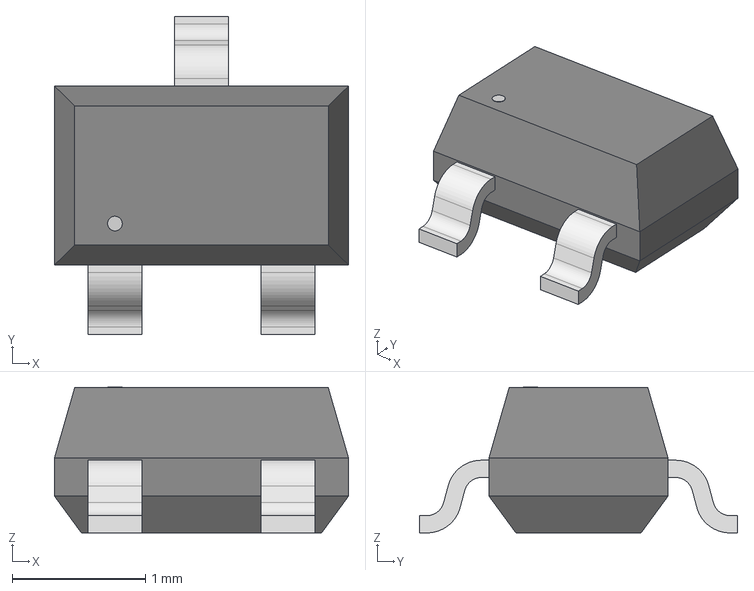
[picture p56: CAD file, 2022-08-25]
Models/Package/SOT323-3L_STM.step
2.21 x 2.39 x 1.09 mm
