mouhandiaye/Kicad/Models/CMS_AOP/SOT-23-5_MC_MCH.step

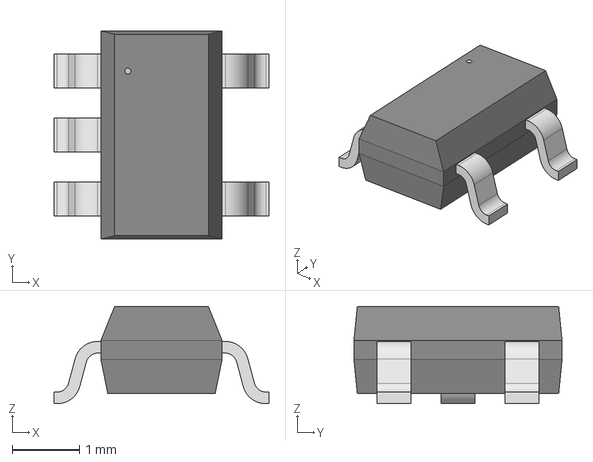
[picture p57: CAD file, 2022-08-02]
Models/CMS_AOP/SOT-23-5_MC_MCH.step
3.20 x 3.10 x 1.45 mm
