mouhandiaye/Kicad/Models/CMS_Capacitor/CCS_CCSTD_0603_L1.75W0.95T0.87B0.35.step

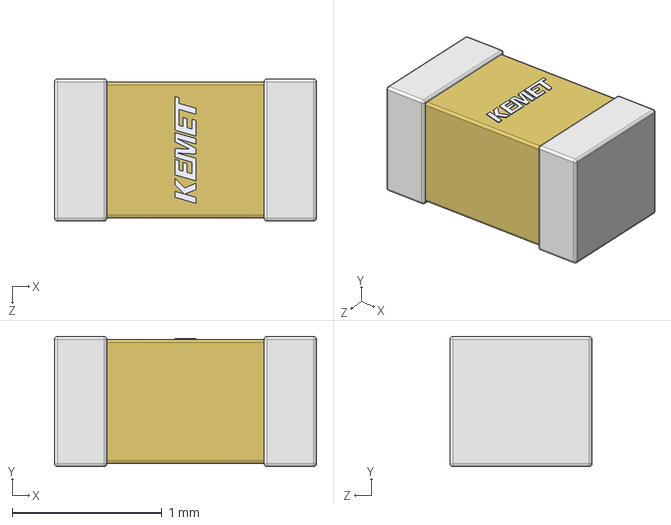
[picture p58: CAD file, 2022-08-02]
Models/CMS_Capacitor/CCS_CCSTD_0603_L1.75W0.95T0.87B0.35.step
1.75 x 0.87 x 0.95 mm
