mouhandiaye/Kicad/Models/CMS_DC_DC/LT8610ACIMSE#PBF.stp

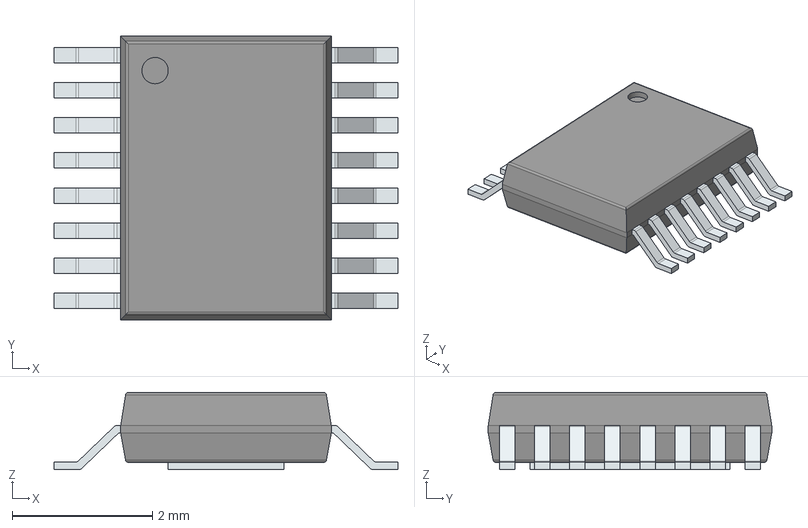
[picture p59: CAD file, 2022-08-25]
Models/CMS_DC_DC/LT8610ACIMSE#PBF.stp
4.90 x 4.04 x 1.10 mm
PinsArrayLR
ThermalPad
