mouhandiaye/Kicad/Models/CMS_IMU/QFN24_4X4X0P9_IVS.step

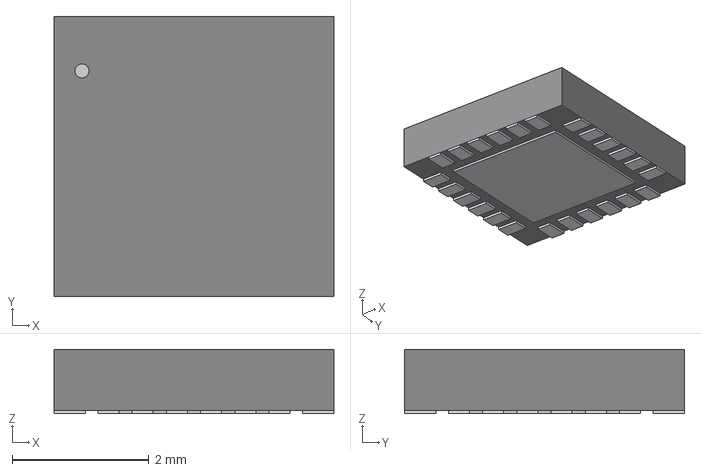
[picture p60: CAD file, 2022-08-02]
Models/CMS_IMU/QFN24_4X4X0P9_IVS.step
4.09 x 4.09 x 0.942 mm
