mouhandiaye/Kicad/Models/CMS_Quartz/MS1V-T1K-32.768KHZ-7PF-20PPM-TA-QC-AU.step

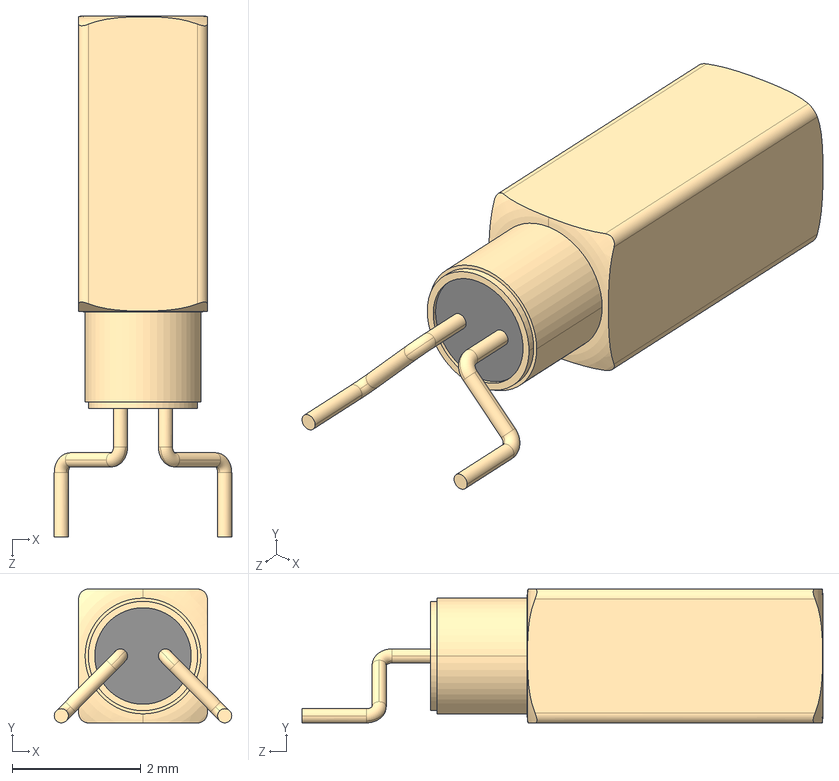
[picture p61: CAD file, 2022-08-02]
Models/CMS_Quartz/MS1V-T1K-32.768KHZ-7PF-20PPM-TA-QC-AU.step
2.76 x 2.08 x 8.10 mm
