mouhandiaye/Kicad/Models/CMS_AOP/MAX4208AUA+.stp

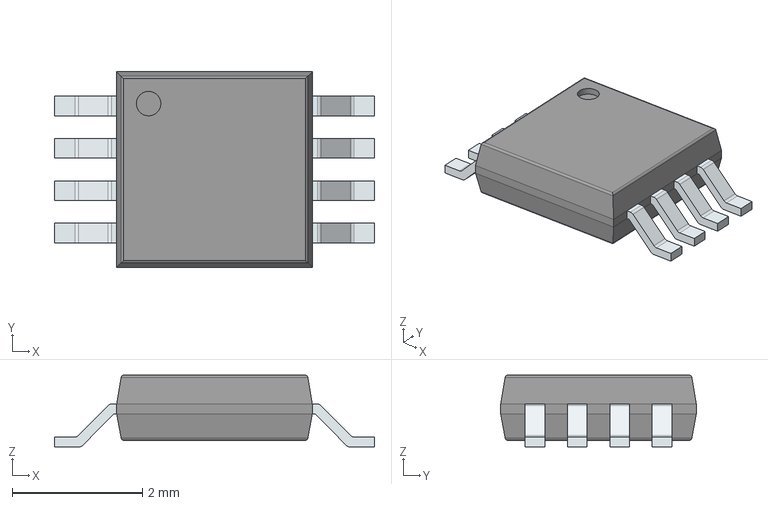
[picture p62: CAD file, 2022-08-02]
Models/CMS_AOP/MAX4208AUA+.stp
4.91 x 3.00 x 1.10 mm
PinsArrayLR
