mouhandiaye/Kicad/Models/CMS_Quartz/CAP_ABS07-32_768KHZ-T_ABR.step

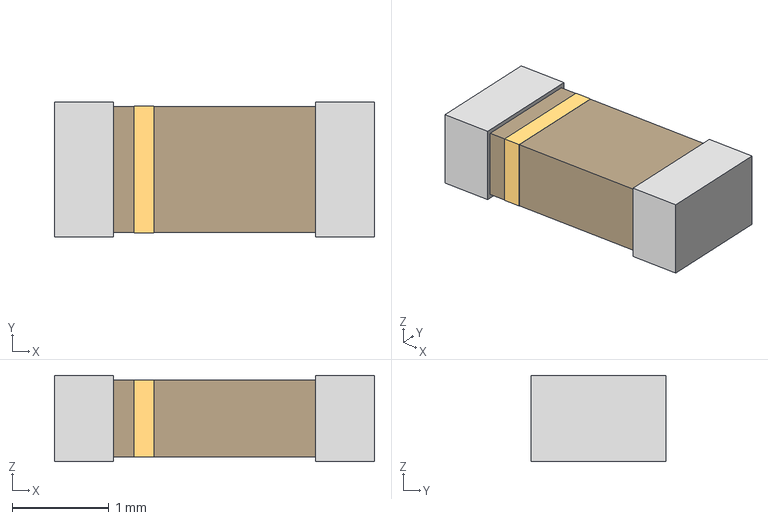
[picture p63: CAD file, 2022-08-02]
Models/CMS_Quartz/CAP_ABS07-32_768KHZ-T_ABR.step
3.30 x 1.40 x 0.889 mm
