mouhandiaye/Kicad/Models/CMS_AOP/TSV912AIDSGR.stp

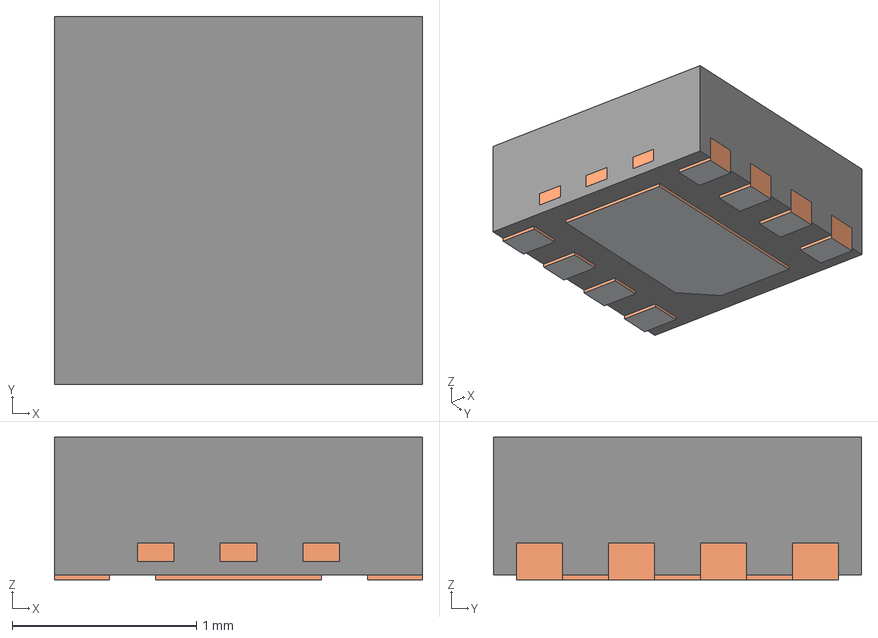
[picture p64: CAD file, 2022-08-02]
Models/CMS_AOP/TSV912AIDSGR.stp
2.00 x 2.00 x 0.775 mm
BODY-SON
FRAME-DSG0008A
PIN1-ID
