mouhandiaye/Kicad/Models/CMS_Inductor/LQH2MCN180K02L_MUR.step

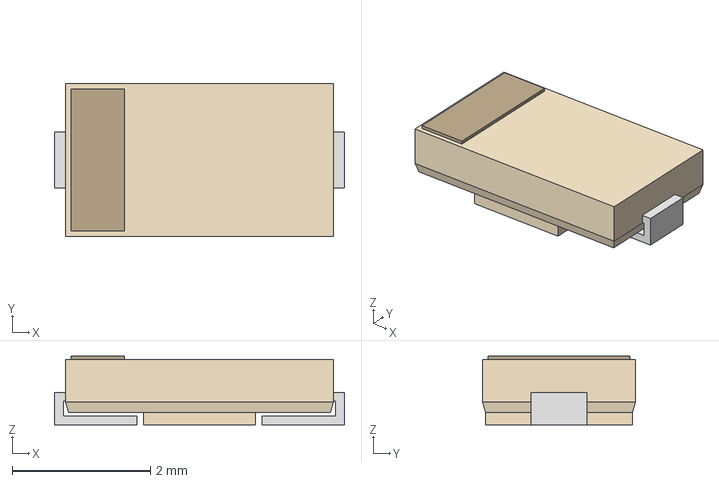
[picture p65: CAD file, 2022-08-02]
Models/CMS_Inductor/LQH2MCN180K02L_MUR.step
4.19 x 2.21 x 0.991 mm
