mouhandiaye/Kicad/Models/CMS_AOP/OPA4991IRUCR.stp

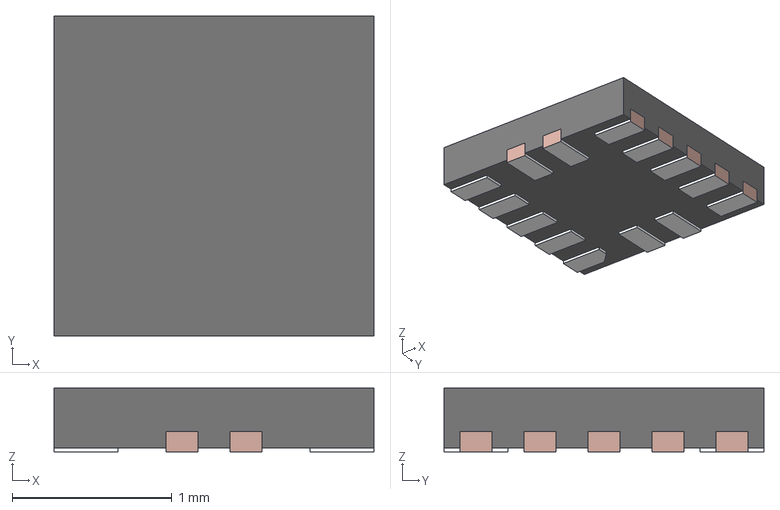
[picture p66: CAD file, 2022-08-02]
Models/CMS_AOP/OPA4991IRUCR.stp
2.00 x 2.00 x 0.4 mm
FRAME
