mouhandiaye/Kicad/Models/CMS_Inductor/IHLP2525CZER2R2M01.stp

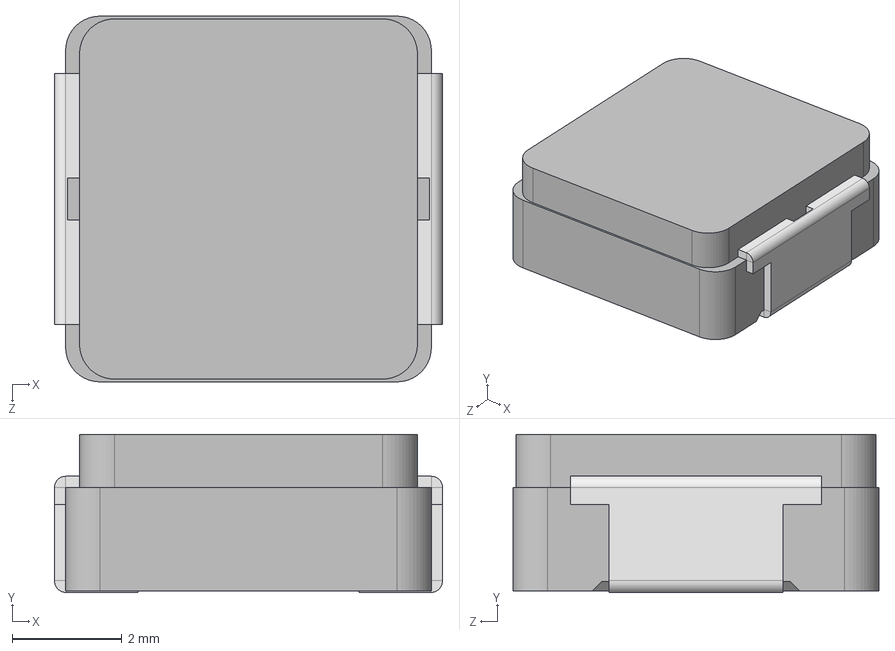
[picture p67: CAD file, 2022-08-02]
Models/CMS_Inductor/IHLP2525CZER2R2M01.stp
7.08 x 2.88 x 6.67 mm
