mouhandiaye/Kicad/Models/CMS_DC_DC/TQFN-20_INR.step

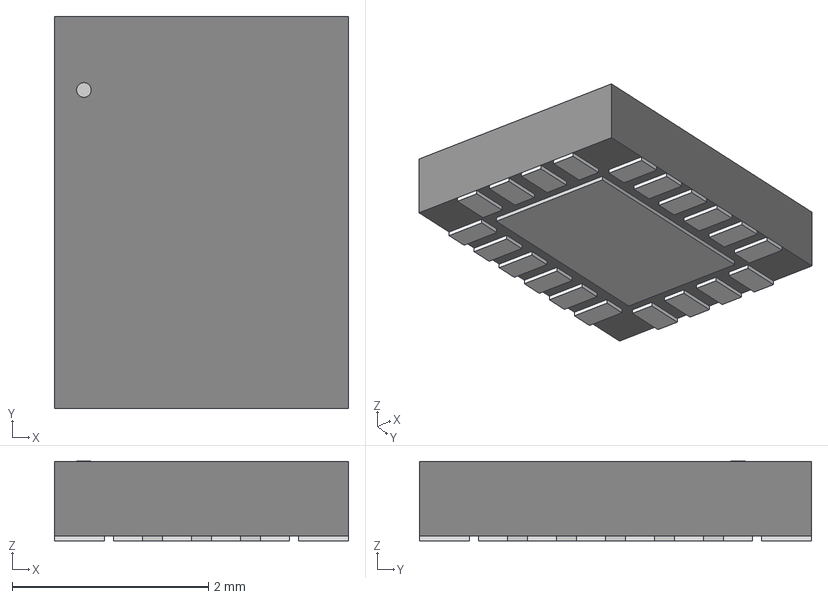
[picture p68: CAD file, 2022-08-02]
Models/CMS_DC_DC/TQFN-20_INR.step
3.00 x 4.00 x 0.815 mm
