mouhandiaye/Kicad/Models/CMS_DC_DC/MSOP8_DIO.step

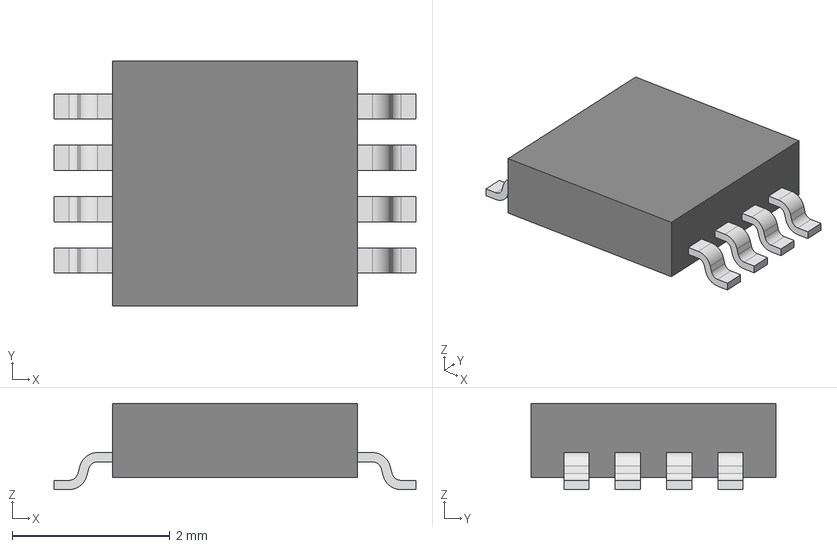
[picture p69: CAD file, 2022-08-02]
Models/CMS_DC_DC/MSOP8_DIO.step
4.58 x 3.10 x 1.09 mm
