mouhandiaye/Kicad/(list of files, cad)

Other CAD files:
Models/CMS_AOP/DGK0008A.stp
Models/Package/MSOP-10_MSE.stp
Models/CMS_DC_DC/LT3991EMSE-5#PBF.stp
Models/CMS_Antenna/ANT016008LCS2442MA2.stp
Models/CMS_Capteur_Pression/MS583702BA21-50.stp
Models/CMS_DC_DC/LMR10510YMFE_NOPB.stp
Models/CMS_DC_DC/MAX25232ATCE_V+.stp
Models/CMS_DC_DC/MCP73831-2ATI_MC.stp
Models/CMS_FPC_FFC/503480-0800.stp
Models/CMS_FPC_FFC/687114183722.stp
Models/CMS_FUSE/045106.3MRL.stp
Models/CMS_Inductor/74438356150.stp
Models/CMS_Inductor/VLS252012HBX-100M-1.stp
Models/CMS_MOLEX/5019400507.step
Models/CMS_MOLEX/Micro_Fit/436500421.stp
Models/CMS_TE/284512-2.stp
Models/CMS_Wurth/665105131822.stp
Models/FPC/52746-0871.stp
Models/Magnetic_Connector/MP009333.STEP
Models/Magnetic_Connector/MP009336.STEP
Models/USB/10118192-0001LF.stp
