mouhandiaye/Kicad/(commit log)

2022-08-02 Migrate to kicad 6
2022-08-09 Ajout lib magnetic connector
2022-08-25 MAJ Brevalan
    [10118192-0001LF.stp, 24FC512-I_MF.stp, 284512-2.stp, 665105131822.stp, 74438356150.stp, 8Z-25.000MAAJ-T.stp, ACAG0201-2450-T.stp, ACM2012-121-2P-T001.stp]
2022-08-26 MAJ LV
    [503480-0800.stp, ADS7028IRTER.stp, KMR223GLFG.stp, LSM6DS3TR-C.stp]
2023-01-19 commit de synchro Léo VENUTI
    [687114183722.stp]
