mouhandiaye/Kicad/(notices)

Notices in the files:
Models/CMS_Samtec/LSHM-120-02.5-L-DV-A-S-K-TR.step:
author */ ('License CC BY-ND 4.0'),
Models/PCI_Connector/PCIE-036-02-F-D-RA.stp:
FILE_NAME( 'e:/temp/worker_256/temp/exporttempdir_7600_139_m64Dr/format_0/PCIE-036-02-F-D-RA.stp', '2022-02-25T13:32:32', ( 'License CC BY-ND 4.0' ), ( 'CADENAS' ), ' ', 'PARTsolutions', ' ' );
